btu-rov/Timsah/CAD_Files/Timsah_3.PNG

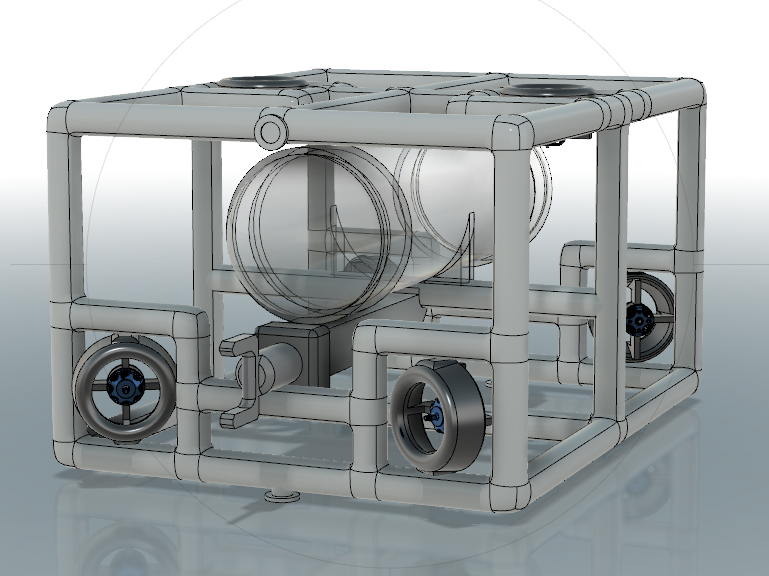
CAD_Files/Timsah_3.PNG
