btu-rov/Timsah/Schemes/time-management.jpg

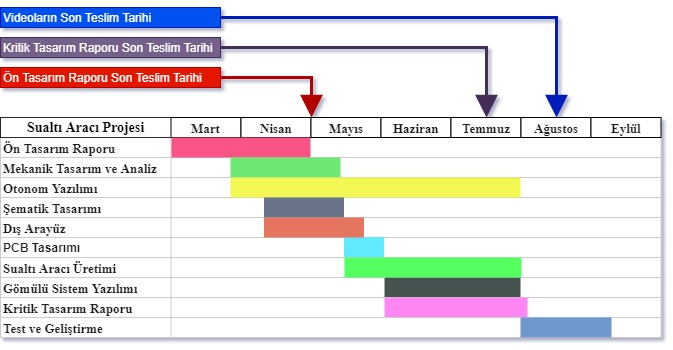
Schemes/time-management.jpg
