btu-rov/Timsah/README.md

# Timsah
This is Open Source ROV project which is made by Bursa Technical University ROV Team.
