btu-rov/Timsah/CAD_Files/Timsah_1.png

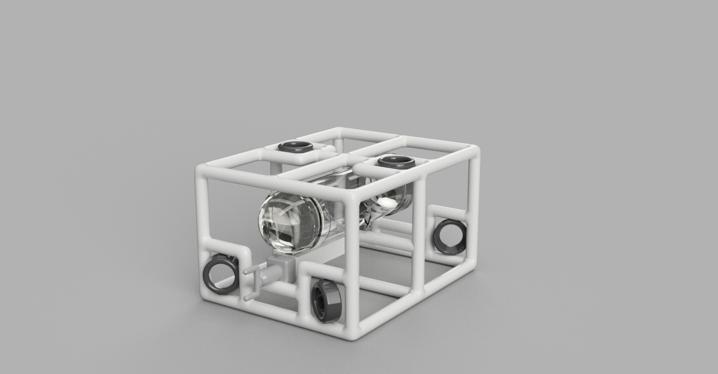
CAD_Files/Timsah_1.png
