btu-rov/Timsah/CAD_Files/Timsah_2.png

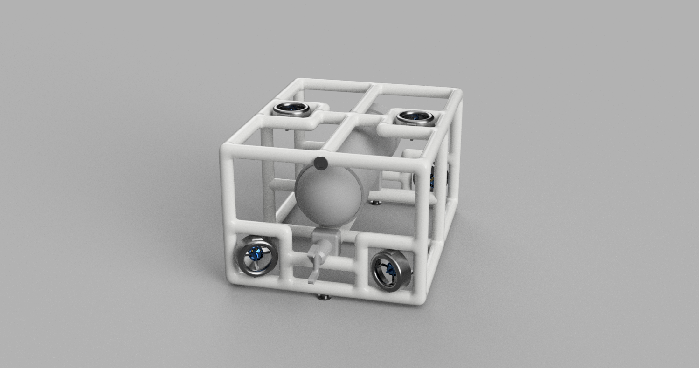
CAD_Files/Timsah_2.png
