btu-rov/Timsah/Schemes/control-center-algorithm.png

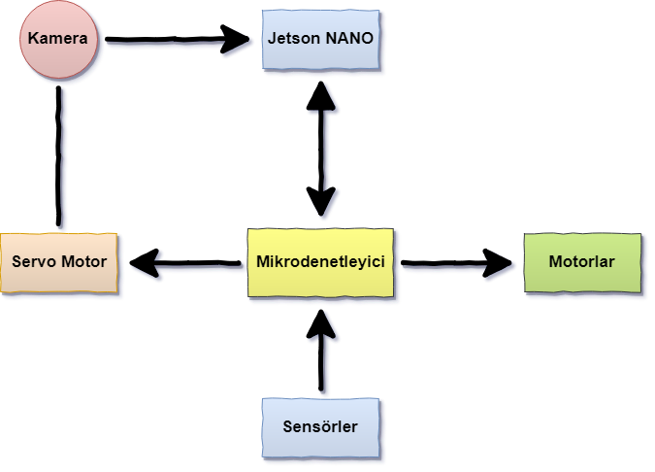
Schemes/control-center-algorithm.png
