btu-rov/Timsah/Schemes/direction-control.png

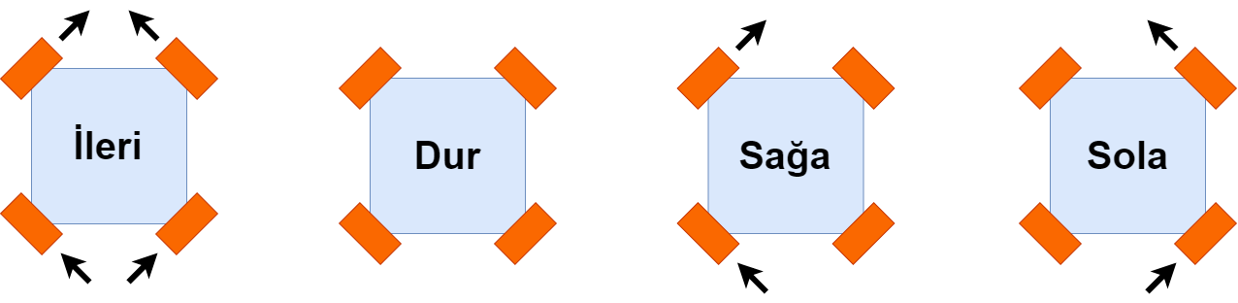
Schemes/direction-control.png
