btu-rov/Timsah/Schemes/ISS_Blok_Diagram.png

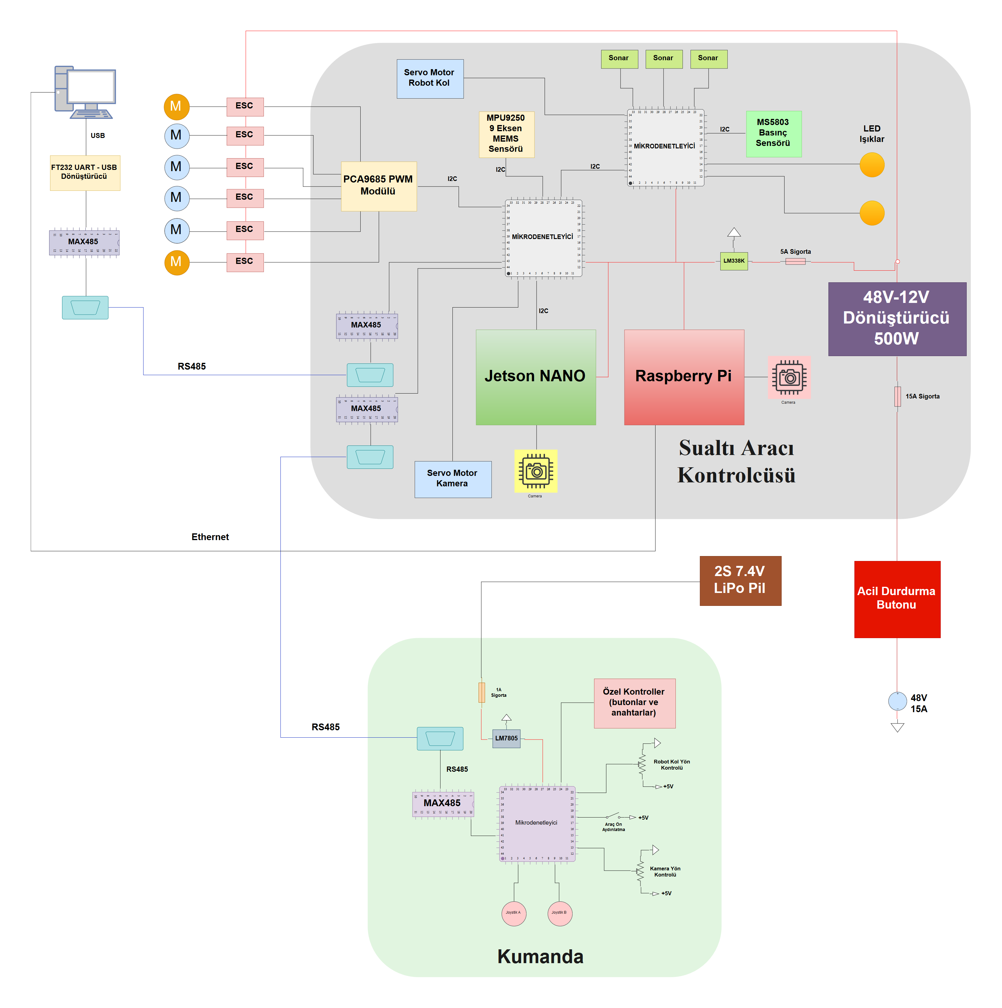
Schemes/ISS_Blok_Diagram.png
