btu-rov/Timsah/Schemes/object-searching-and-moving.png

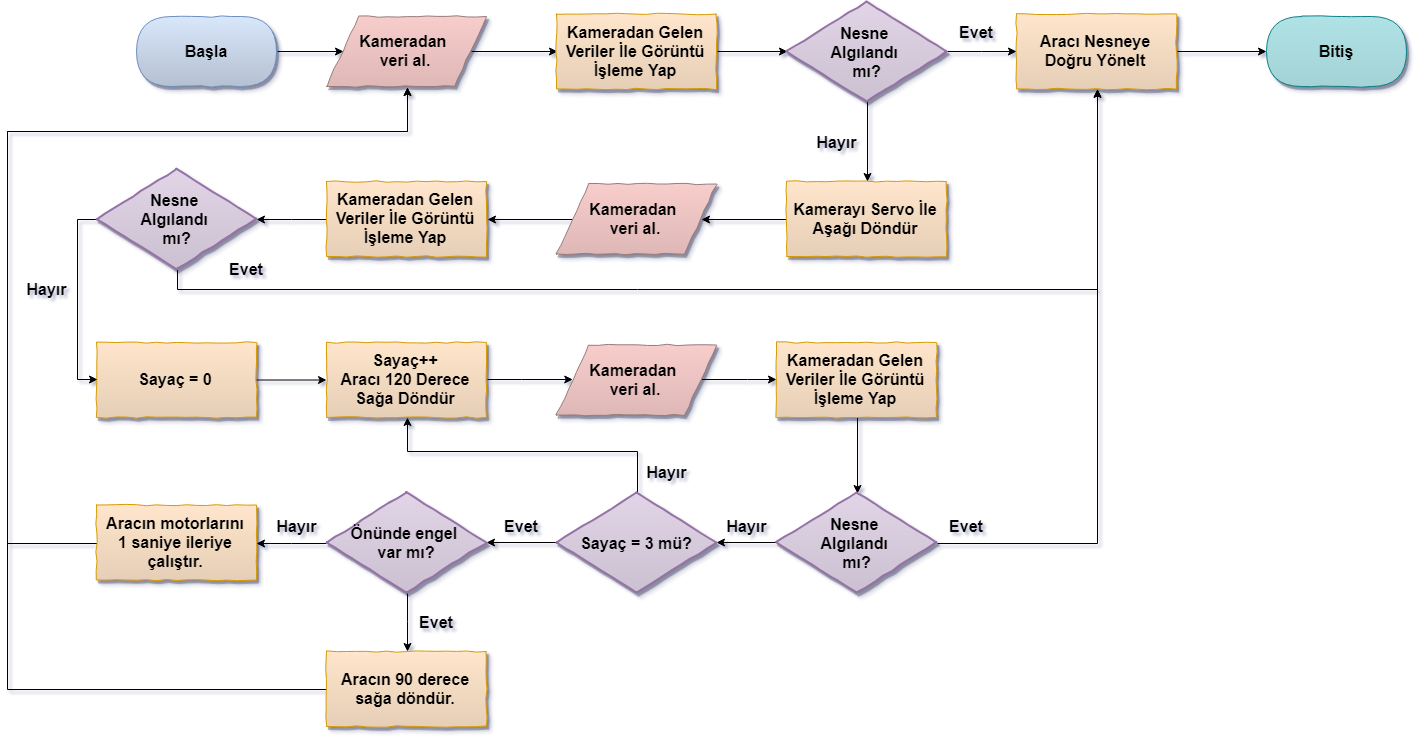
Schemes/object-searching-and-moving.png
