btu-rov/Timsah/Schemes/organization-schema.png

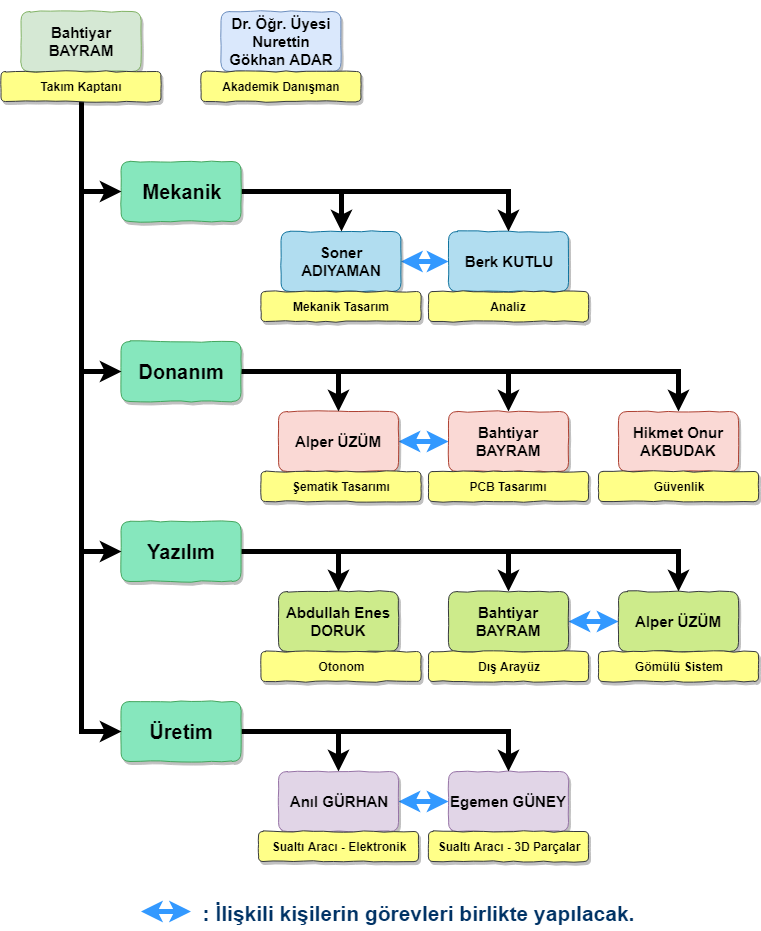
Schemes/organization-schema.png
