btu-rov/Timsah/Schemes/time-management.png

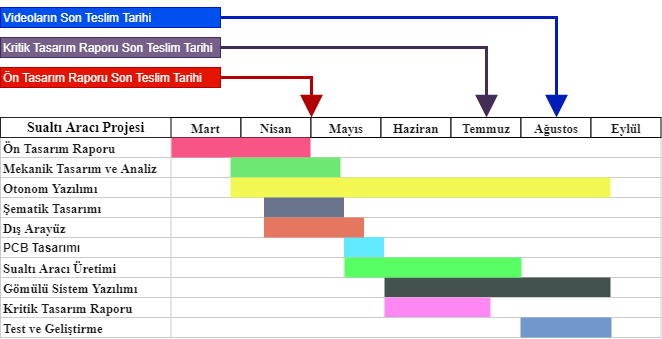
Schemes/time-management.png
