btu-rov/Timsah/Timsah_Remote-Control/Timsah_Remote-Control-3D.png

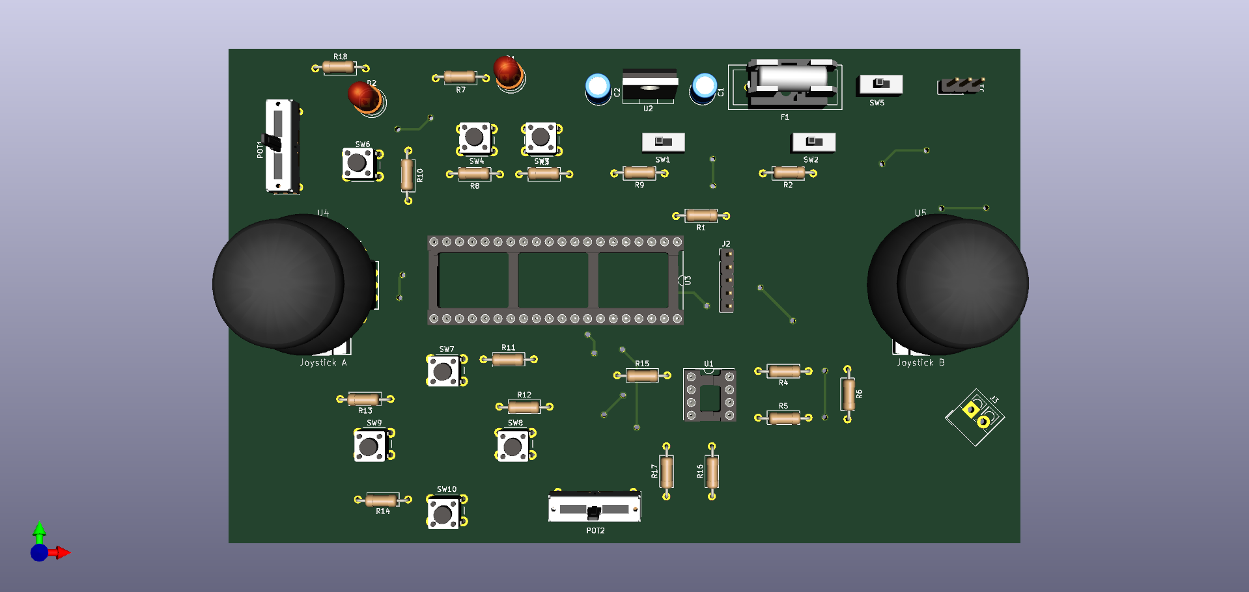
Timsah_Remote-Control/Timsah_Remote-Control-3D.png
