btu-rov/Timsah/Timsah_Remote-Control/Timsah_Remote_Control-B_Cu.PNG

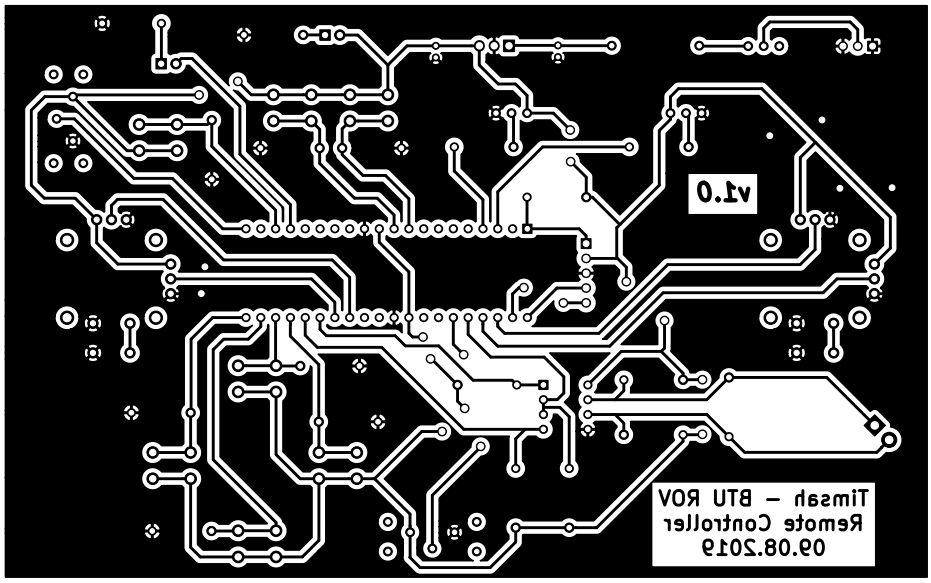
Timsah_Remote-Control/Timsah_Remote_Control-B_Cu.PNG
