btu-rov/Timsah/TimsahGUI/TimsahGUI.PNG

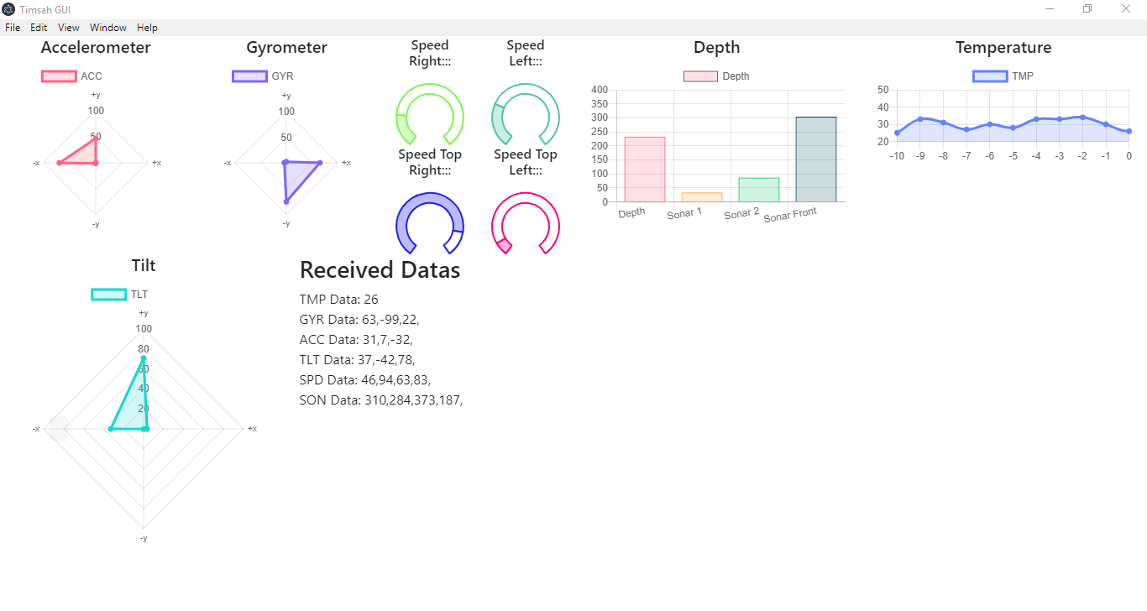
TimsahGUI/TimsahGUI.PNG
