btu-rov/Timsah/CAD_Files/Transparent_Tube.step

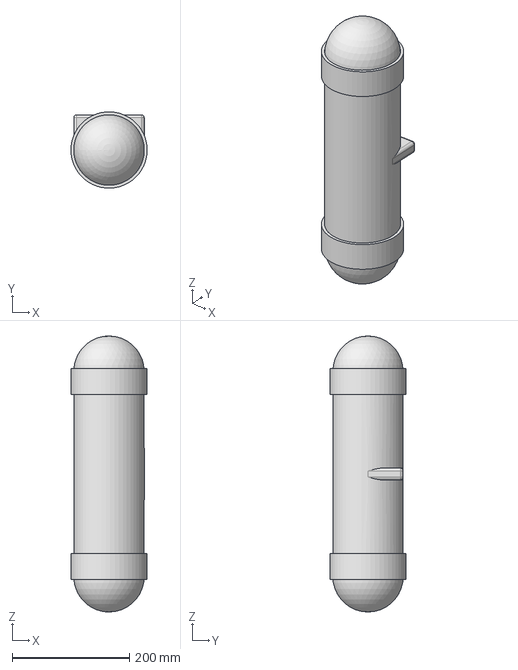
[picture p14: CAD file, 2019-05-17]
CAD_Files/Transparent_Tube.step
129.9 x 129.9 x 470.0 mm
