btu-rov/Timsah/Timsah_Main_Board/3D-Parts/Adafruit_BNO055_AP214.STEP

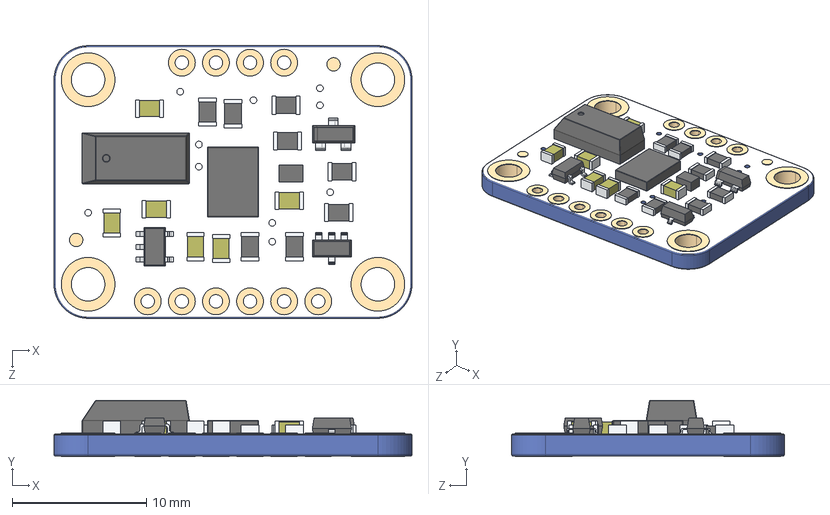
[picture p15: CAD file, 2019-08-28]
Timsah_Main_Board/3D-Parts/Adafruit_BNO055_AP214.STEP
26.7 x 4.20 x 20.3 mm
