btu-rov/Timsah/Timsah_Remote-Control/3D-Parts/Slide potentiometers.step

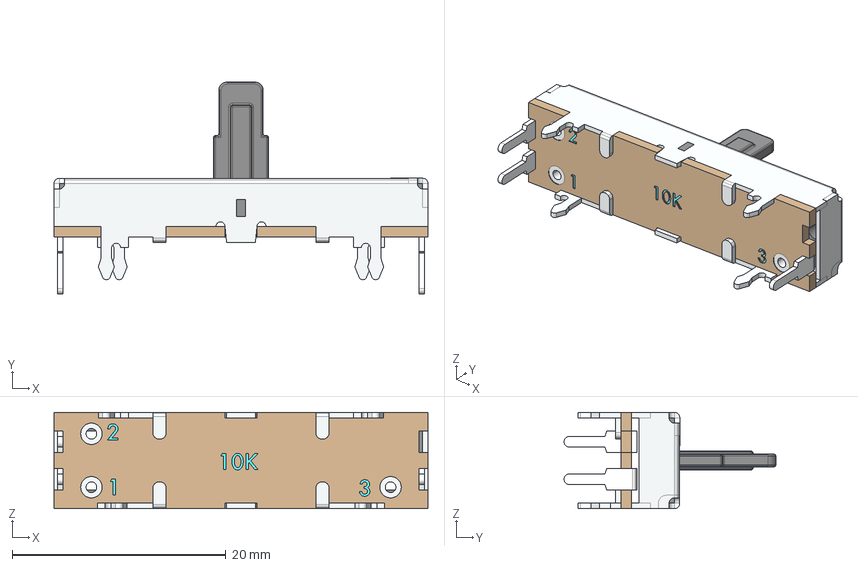
[picture p16: CAD file, 2019-07-26]
Timsah_Remote-Control/3D-Parts/Slide potentiometers.step
35.0 x 19.8 x 9.00 mm
