btu-rov/Timsah/CAD_Files/Motor_Holder.step

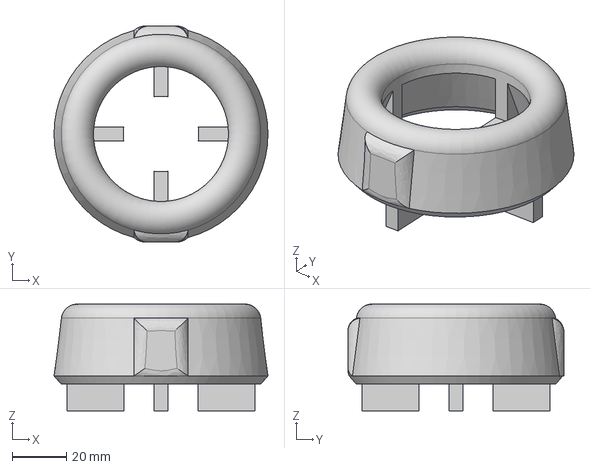
[picture p17: CAD file, 2019-05-17]
CAD_Files/Motor_Holder.step
79.3 x 80.0 x 39.6 mm
