btu-rov/Timsah/Timsah_Remote-Control/3D-Parts/Joystickcolor.step

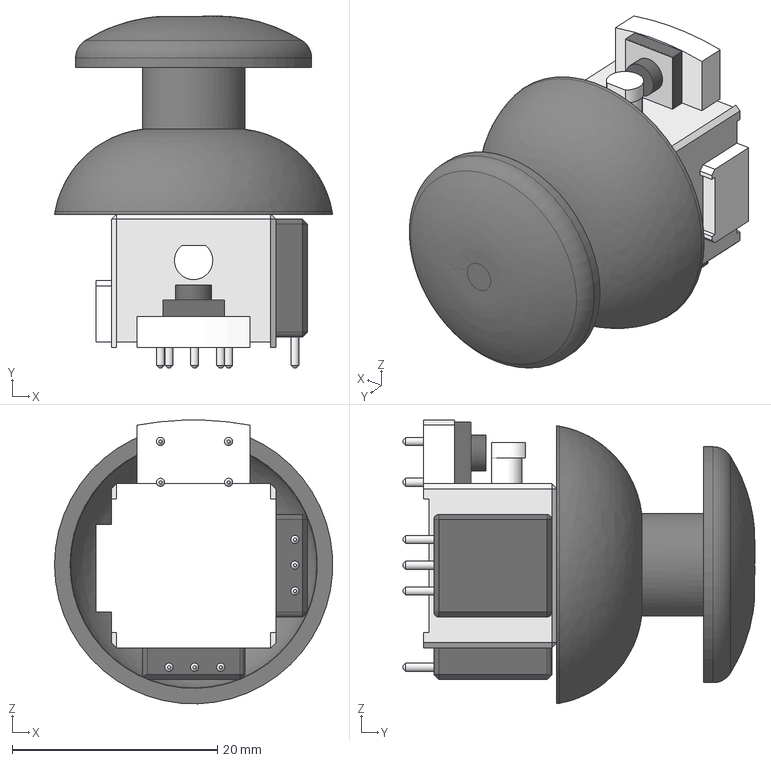
[picture p18: CAD file, 2019-07-26]
Timsah_Remote-Control/3D-Parts/Joystickcolor.step
27.1 x 34.3 x 27.6 mm
