btu-rov/Timsah/CAD_Files/Sonar.step

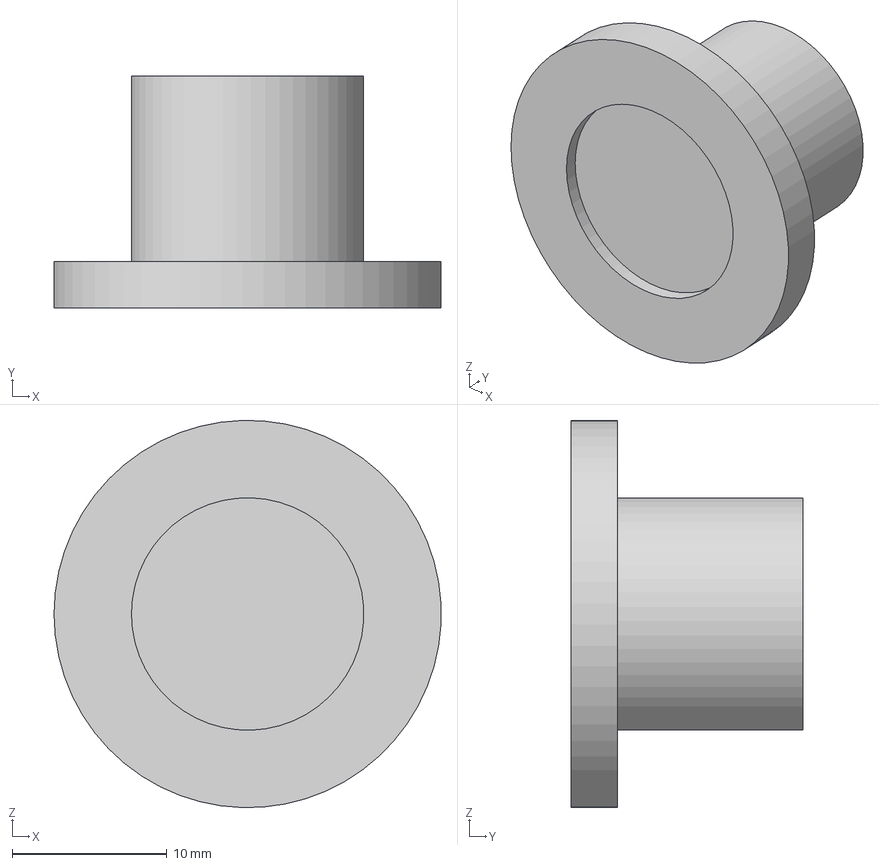
[picture p19: CAD file, 2019-05-17]
CAD_Files/Sonar.step
25.0 x 15.0 x 25.0 mm
