btu-rov/Timsah/Timsah_Main_Board/3D-Parts/Vertical slide switch SS-12D00G3 High Knob 3mm SPDT v2.step

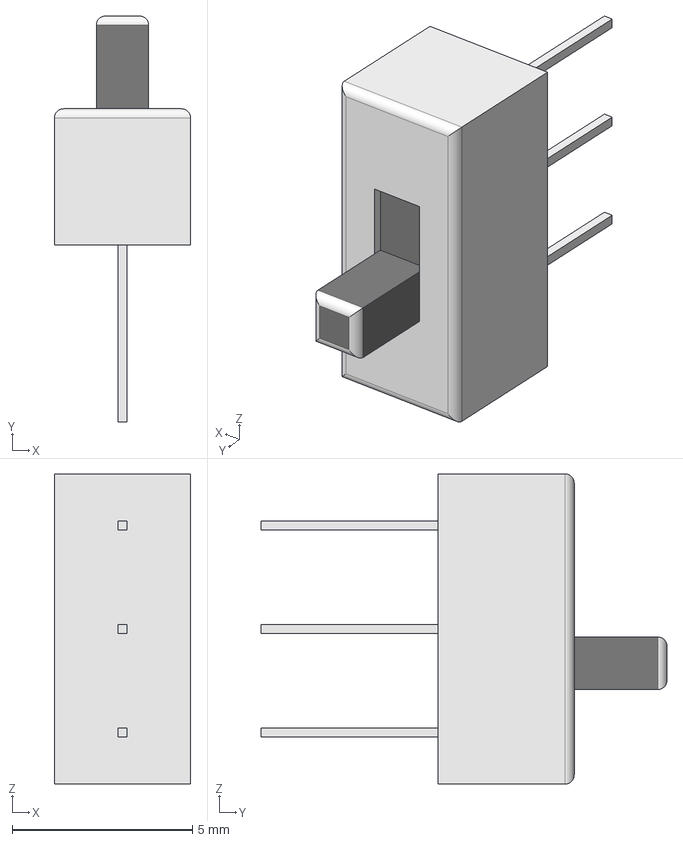
[picture p20: CAD file, 2019-07-26]
Timsah_Main_Board/3D-Parts/Vertical slide switch SS-12D00G3 High Knob 3mm SPDT v2.step
3.77 x 11.2 x 8.59 mm
