btu-rov/Timsah/CAD_Files/Robot_Arm.step

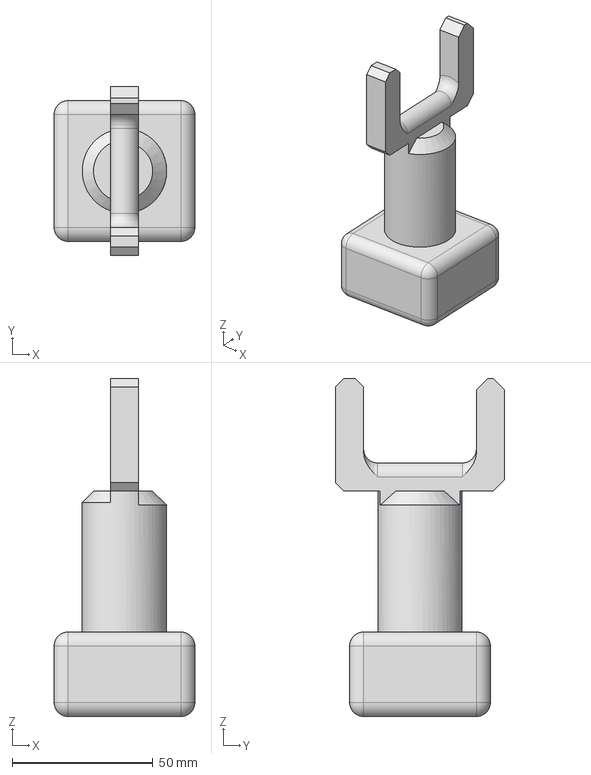
[picture p21: CAD file, 2019-05-17]
CAD_Files/Robot_Arm.step
50.0 x 60.0 x 120.0 mm
