btu-rov/Timsah/Timsah_Main_Board/3D-Parts/LITTLEFUSE_FuseBlock_646_v2.step

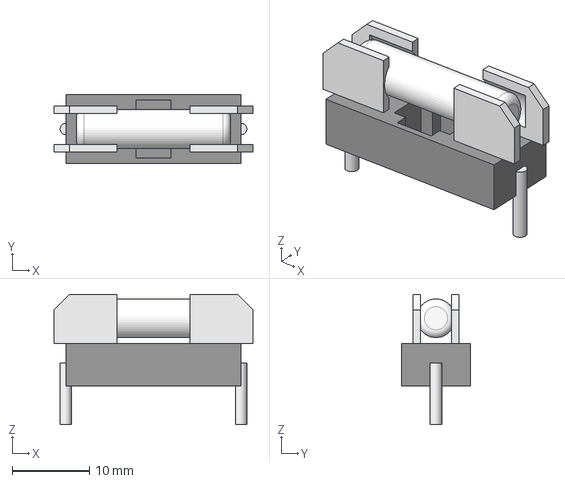
[picture p22: CAD file, 2019-07-26]
Timsah_Main_Board/3D-Parts/LITTLEFUSE_FuseBlock_646_v2.step
25.8 x 9.00 x 16.9 mm
