btu-rov/Timsah/Timsah_Main_Board/3D-Parts/ScrewTerminal.STEP

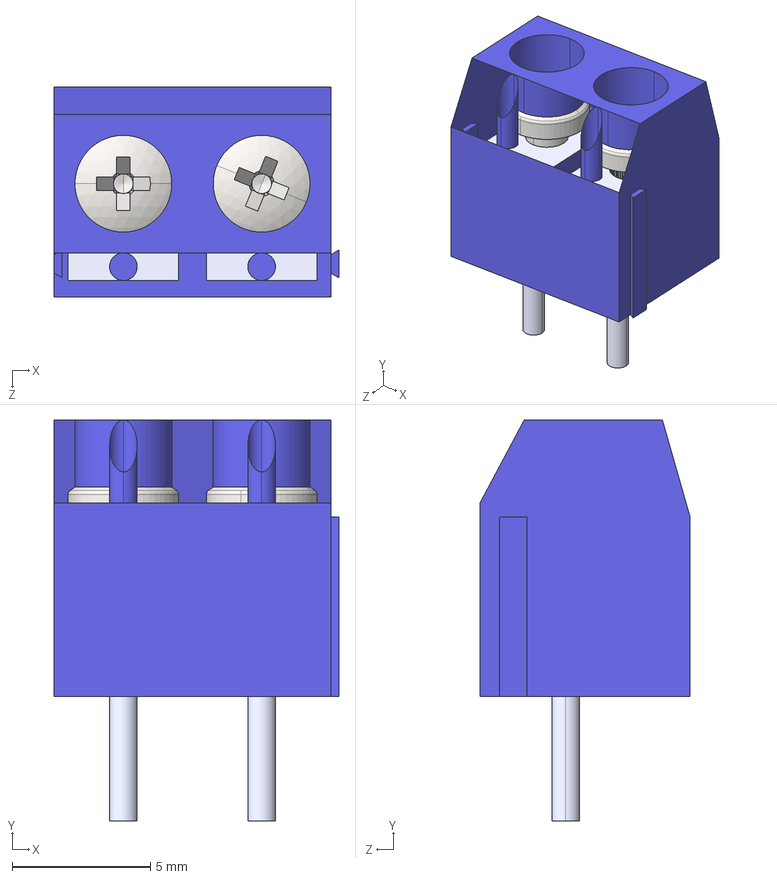
[picture p23: CAD file, 2019-08-28]
Timsah_Main_Board/3D-Parts/ScrewTerminal.STEP
10.3 x 14.5 x 7.60 mm
ScrewTerminalCover
Pin x 2
pan head cross recess screw_iso_ISO 7045 - M2 x 3 - Z - 3N x 2
