btu-rov/Timsah/Schemes/image-processing-steps.png

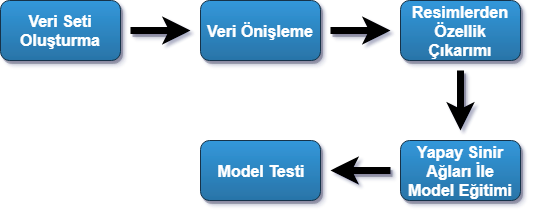
Schemes/image-processing-steps.png
