btu-rov/Timsah/Timsah_Main_Board/Timsah_Main_Board.pdf

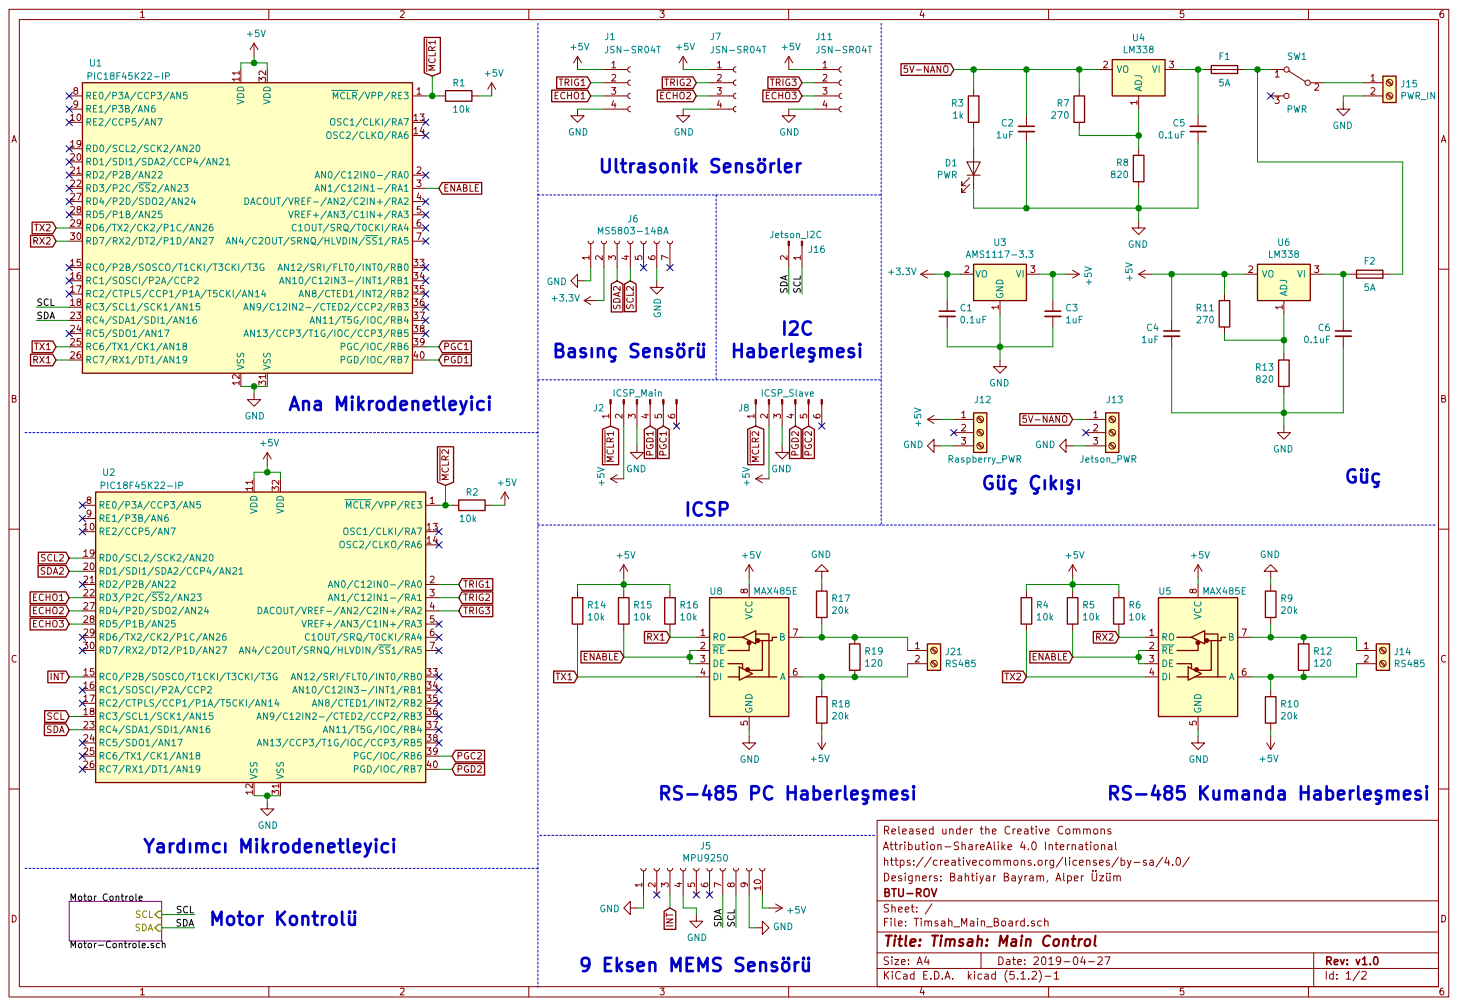
[picture p25: page 1]

Jetson_I2C

ICSP

https://creativecommons.org/licenses/by-sa/4.0/ Attribution-ShareAlike 4.0 International Released under the Creative Commons

File: Timsah_Main_Board.sch Sheet: / BTU-ROV Designers: Bahtiyar Bayram, Alper Üzüm

Motor Controle Motor-Controle.sch SCL SDA

Id: 1/2 Title: Timsah: Main Control

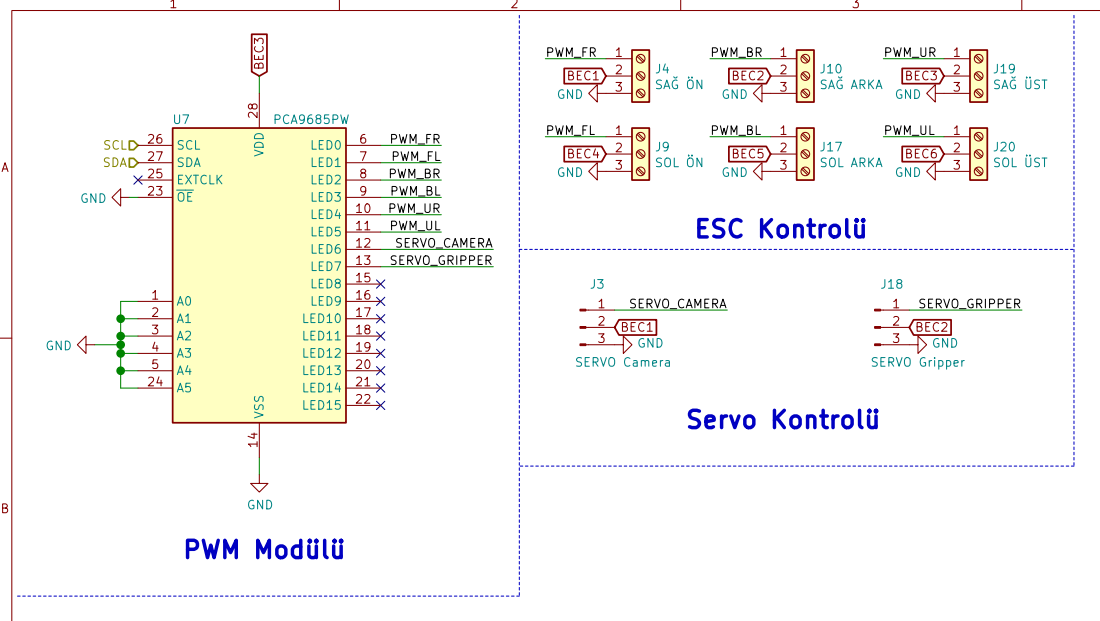
[picture p26: page 2]

Id: 2/2 Title: File: Motor-Controle.sch Sheet: /Motor Controle/
