btu-rov/Timsah/Schemes/ISS_Blok_Diagram.pdf

# MİKRODENETLEYİCİ

# ESC

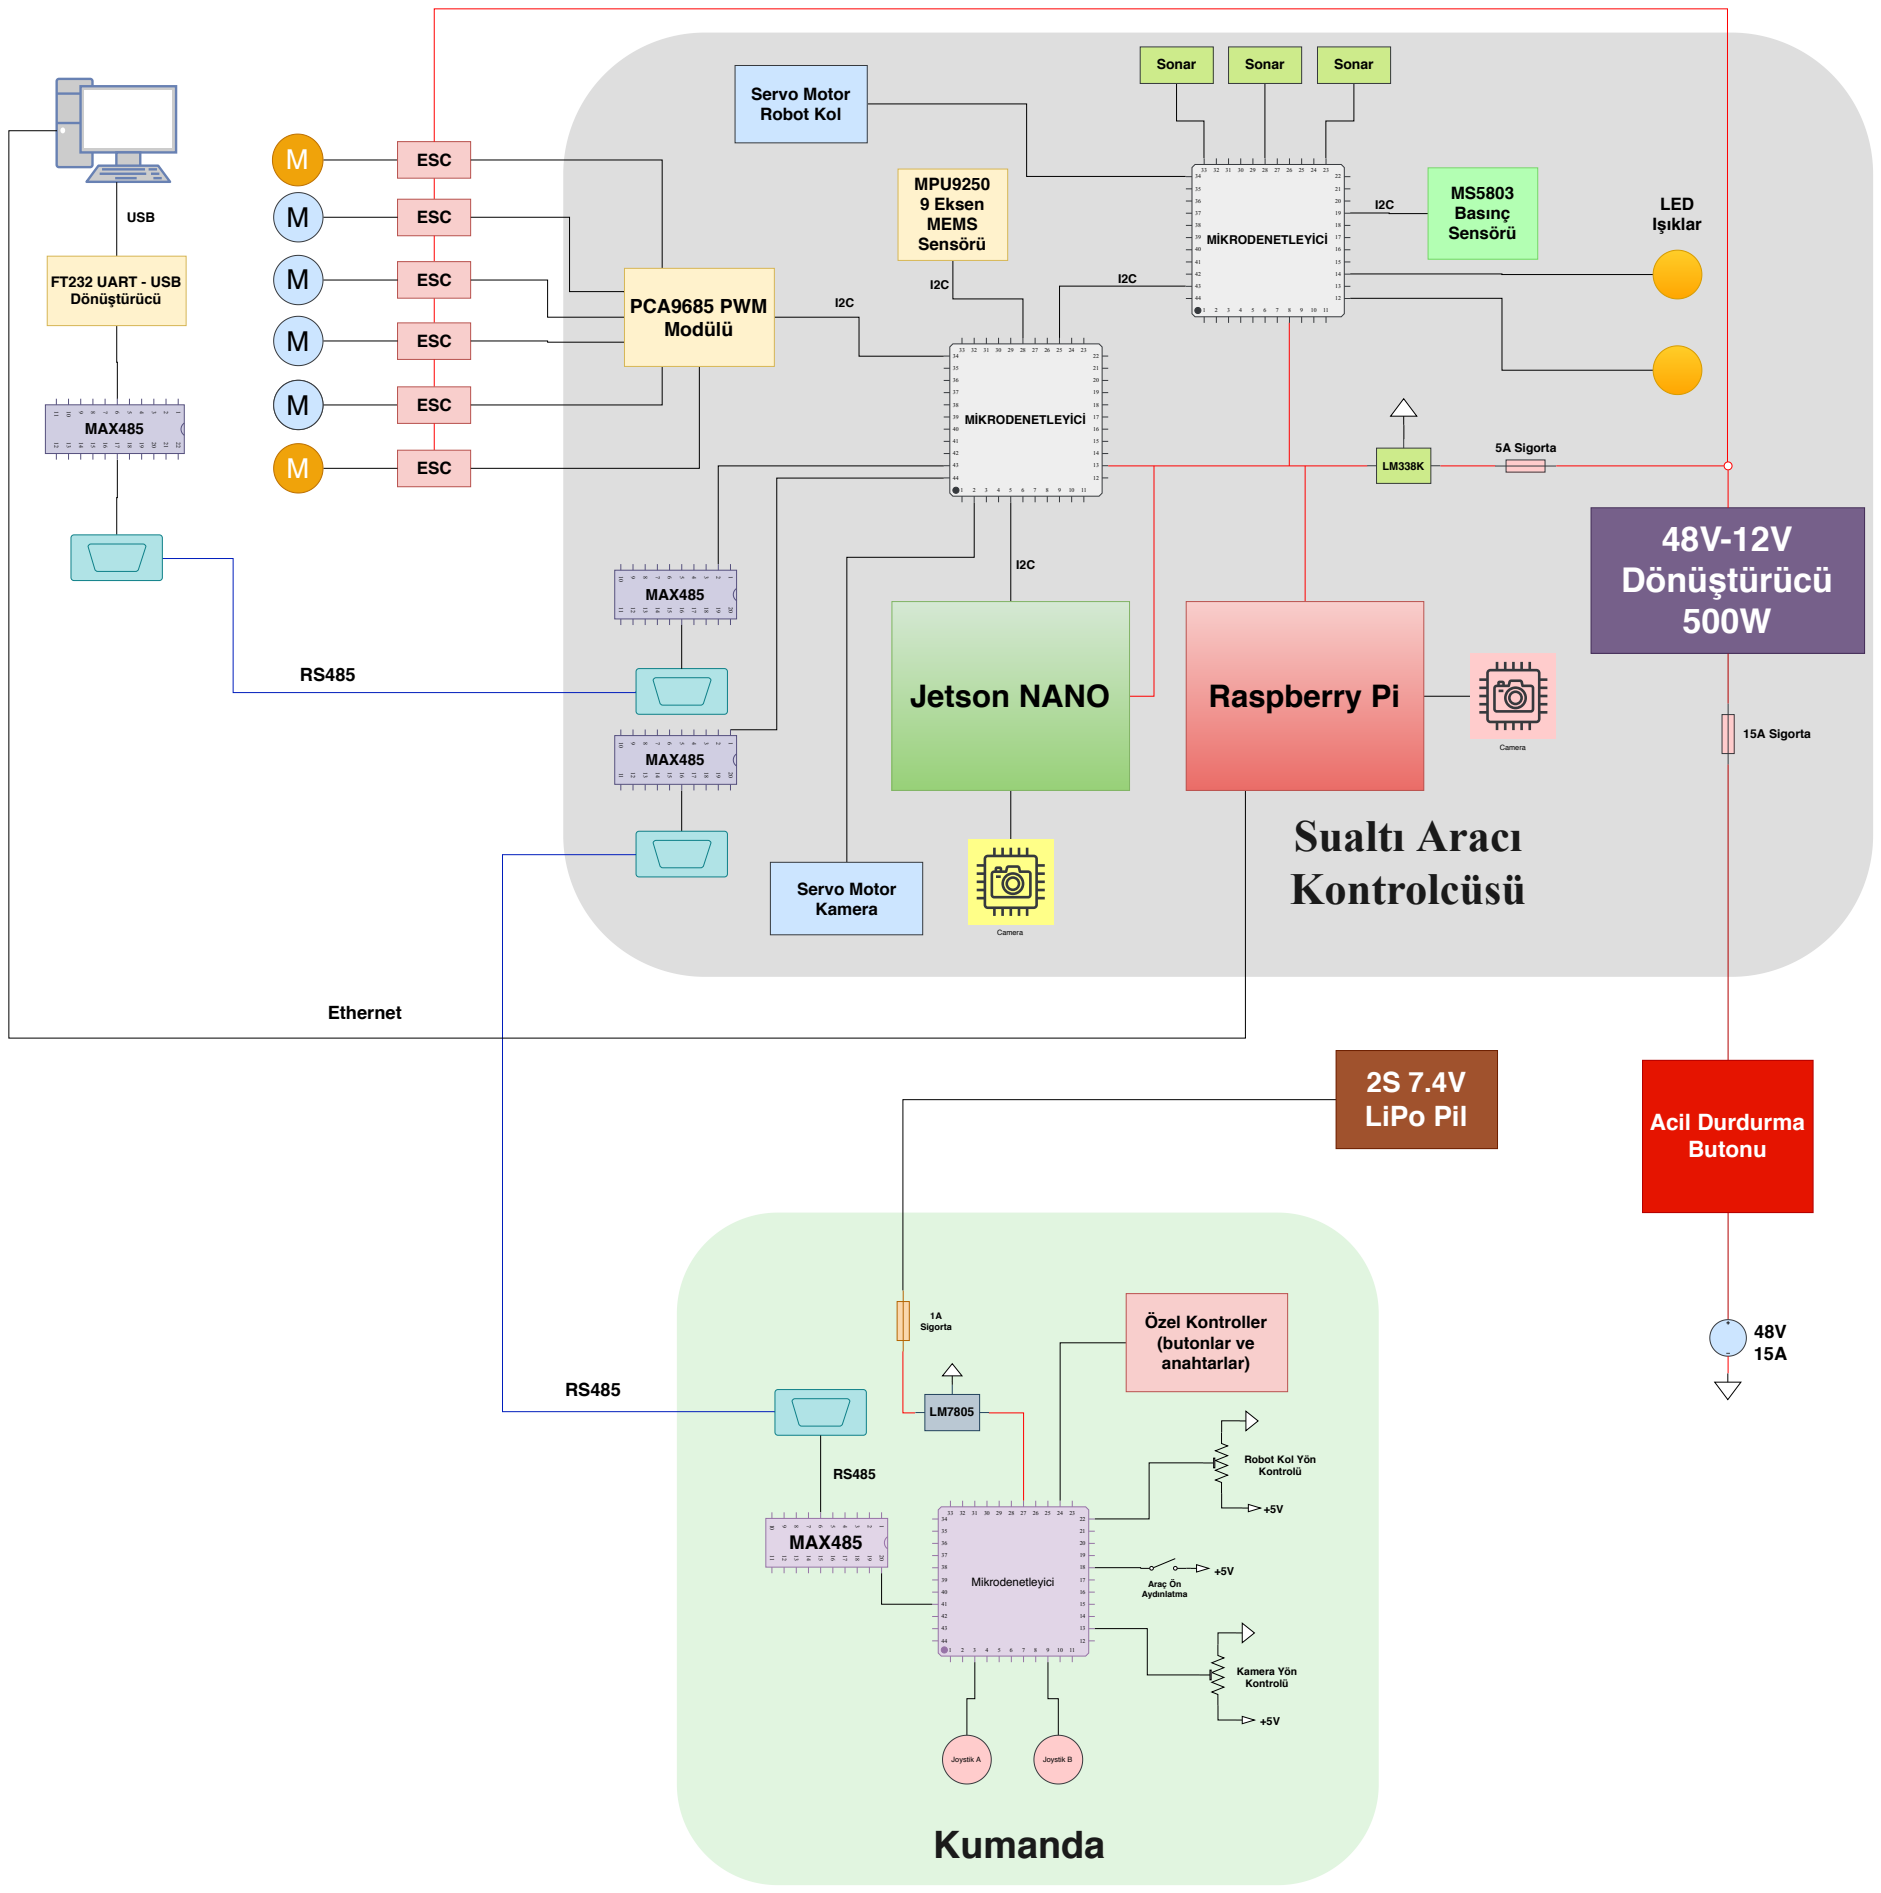
[picture p27: page 1]
ESC; MPU9250 9 Eksen MEMS Sensörü; Jetson NANO; Camera; 5A Sigorta; Servo Motor Kamera; Sonar; MAX485; USB; Sualtı Aracı Kontrolcüsü; Mikrodenetleyici; 1A Sigorta; Joystik A; Joystik B; Araç Ön Aydınlatma; Kamera Yön Kontrolü; Kumanda; Özel Kontroller (butonlar ve anahtarlar); MİKRODENETLEYİCİ; MS5803 Basınç Sensörü; LED; Işıklar; Raspberry Pi; Ethernet; FT232 UART - USB Dönüştürücü; 48V-12V Dönüştürücü 500W; PCA9685 PWM Modülü; Servo Motor Robot Kol; 2S 7.4V LiPo Pil; 15A Sigorta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

Robot Kol Yön
Kontrolü
