btu-rov/Timsah/Timsah_Remote-Control/Timsah_Remote-Control-B_Cu.pdf

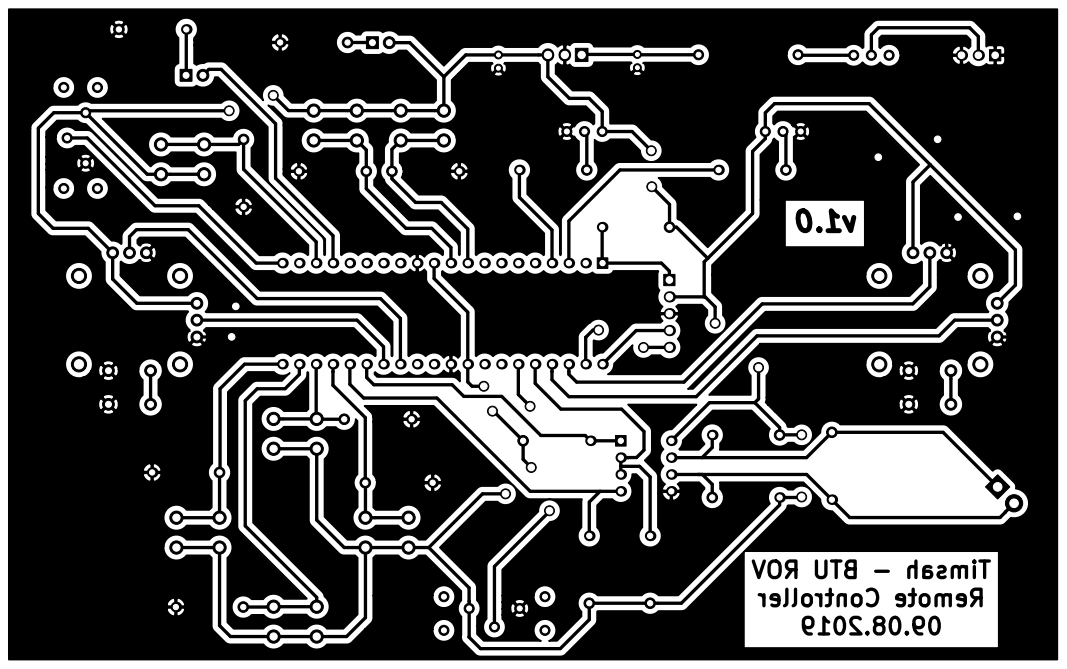
[picture p28: page 1]
