btu-rov/Timsah/Timsah_Remote-Control/Timsah_Remote-Control.pdf

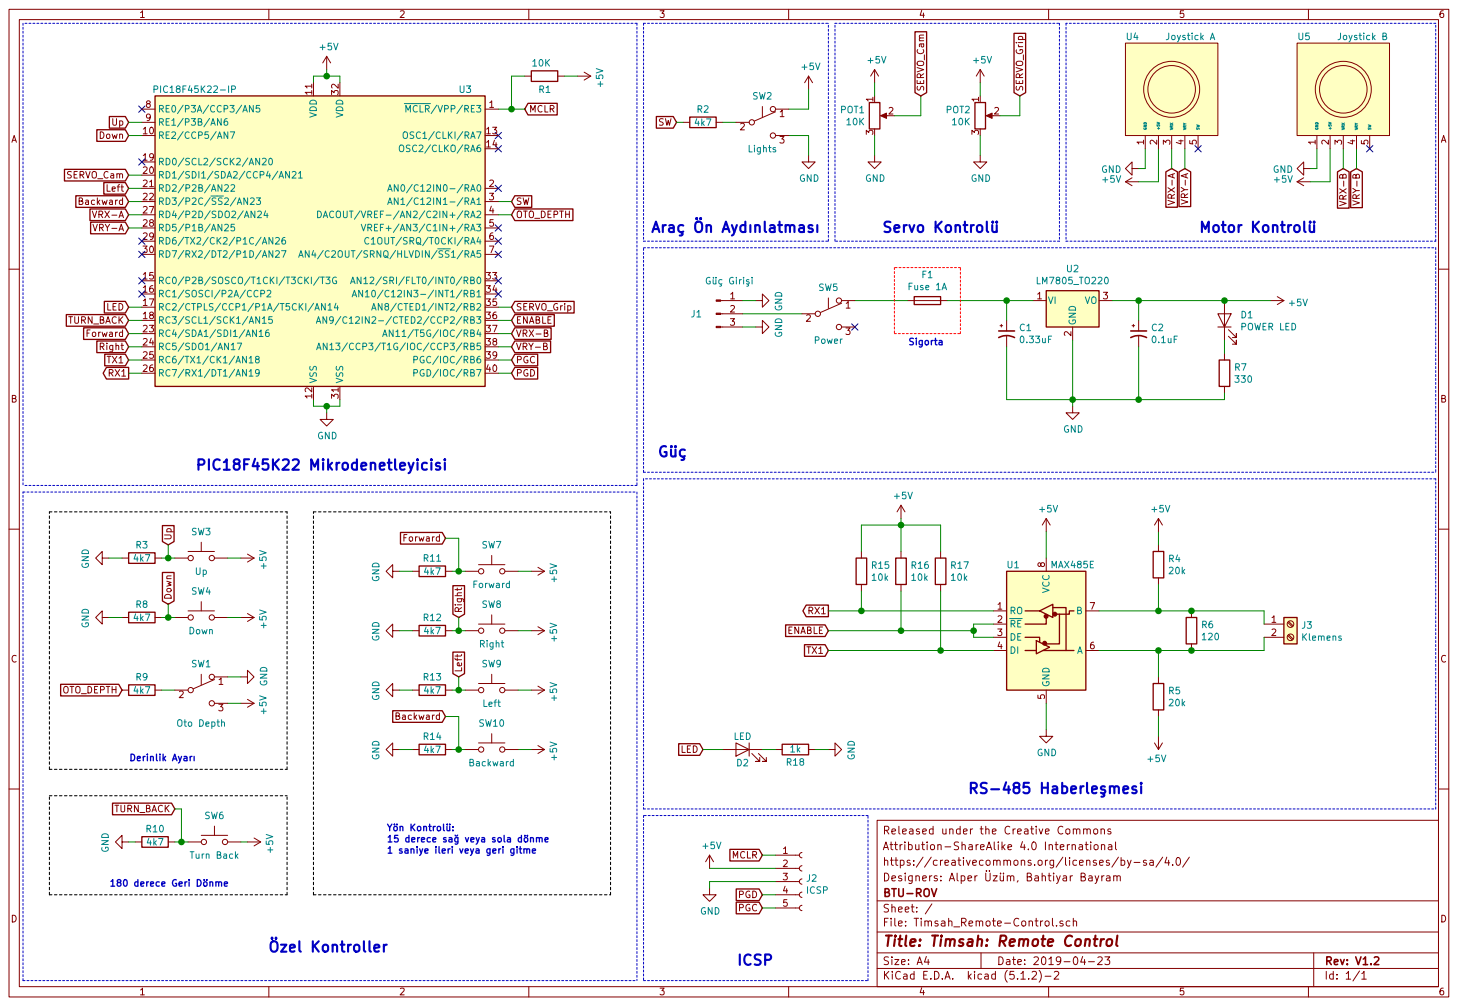
[picture p29: page 1]
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

1 saniye ileri veya geri gitme

File: Timsah_Remote-Control.sch Sheet: / BTU-ROV Designers: Alper Üzüm, Bahtiyar Bayram

Id: 1/1 Title: Timsah: Remote Control
