btu-rov/Timsah/Timsah_Main_Board/Timsah_Main_Board.kicad_pcb

## KiCad design Timsah_Main_Board/Timsah_Main_Board.kicad_pcb (2019-08-29)

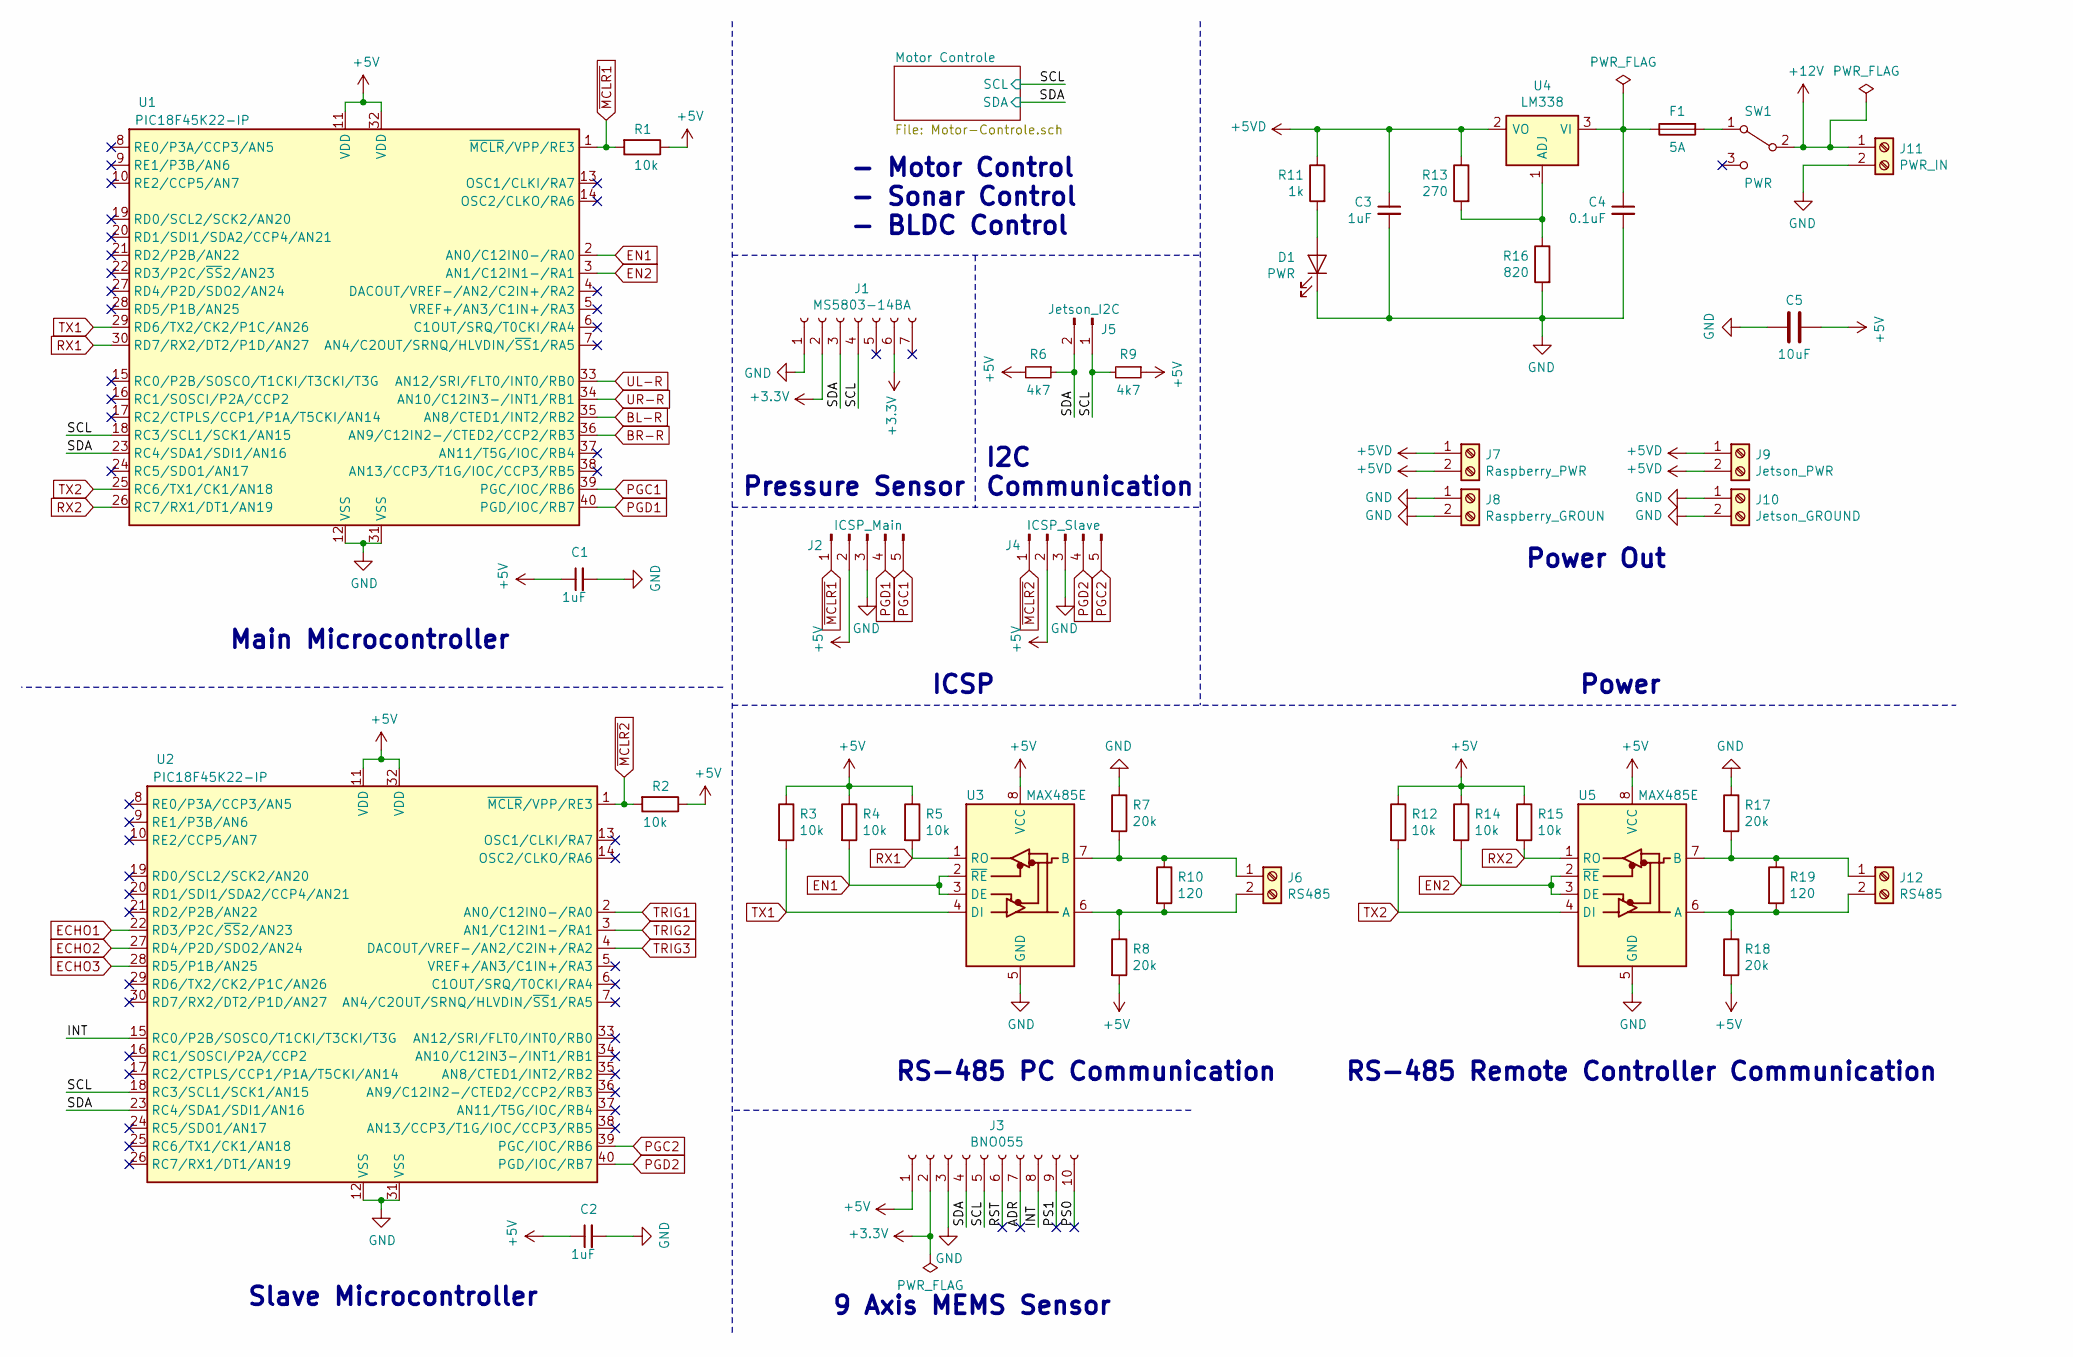
[picture p30: schematic Timsah_Main_Board.sch, Timsah: Main Control]

Parts:
C1, C2, C3: 1uF; C_0805_2012Metric_Pad1.15x1.40mm_HandSolder
C4: 0.1uF; C_0805_2012Metric_Pad1.15x1.40mm_HandSolder
C5: 10uF; C_0805_2012Metric_Pad1.15x1.40mm_HandSolder
D1: PWR; LED_0805_2012Metric_Pad1.15x1.40mm_HandSolder
F1: 5A; Fuseholder_23x9x10mm
J1: MS5803-14BA; PinSocket_1x07_P2.54mm_Vertical
J2: ICSP_Main; PinSocket_1x05_P2.54mm_Vertical
J3: BNO055; BNO055-Module_Adafruit
J4: ICSP_Slave; PinSocket_1x05_P2.54mm_Vertical
J5: Jetson_I2C; PinHeader_1x02_P2.54mm_Vertical
J6, J12: RS485; TerminalBlock_4Ucon_1x02_P3.50mm_Vertical
J7: Raspberry_PWR; TerminalBlock_4Ucon_1x02_P3.50mm_Vertical
J8: Raspberry_GROUN; TerminalBlock_4Ucon_1x02_P3.50mm_Vertical
J9: Jetson_PWR; TerminalBlock_4Ucon_1x02_P3.50mm_Vertical
J10: Jetson_GROUND; TerminalBlock_4Ucon_1x02_P3.50mm_Vertical
J11: PWR_IN; TerminalBlock_bornier-2_P5.08mm
R1, R2, R3, R4, R5, R12, R14, R15: 10k; R_0805_2012Metric_Pad1.15x1.40mm_HandSolder
R6, R9: 4k7; R_0805_2012Metric_Pad1.15x1.40mm_HandSolder
R7, R8, R17, R18: 20k; R_0805_2012Metric_Pad1.15x1.40mm_HandSolder
R10, R19: 120; R_Axial_DIN0207_L6.3mm_D2.5mm_P10.16mm_Horizontal
R11: 1k; R_0805_2012Metric_Pad1.15x1.40mm_HandSolder
R13: 270; R_Axial_DIN0207_L6.3mm_D2.5mm_P10.16mm_Horizontal
R16: 820; R_Axial_DIN0207_L6.3mm_D2.5mm_P10.16mm_Horizontal
SW1: PWR; SW_Slide_1P2T_0.105pitch
U1, U2: PIC18F45K22-IP; DIP-40_W15.24mm_Socket
U3, U5: MAX485E; DIP-8_W7.62mm_Socket
U4: LM338; TO-3

Connections:
+3V3: J1.2, J1.6, J3.2
+5VD: C3.1, J7.1, J7.2, J9.1, J9.2, R11.1, R13.1, U4.2 (VO)
+12V: J11.1, SW1.2 (B); also elsewhere on the board
/ADR: J3.7
/INT: J3.8, U2.15 (RC0/P2B/SOSCO/T1CKI/T3CKI/T3G)
/PS0: J3.10
/PS1: J3.9
/RST: J3.6
/SCL: J1.4, J3.5, J5.1, R9.2, U1.18 (RC3/SCL1/SCK1/AN15), U2.18 (RC3/SCL1/SCK1/AN15); also elsewhere on the board
/SDA: J1.3, J3.4, J5.2, R6.1, U1.23 (RC4/SDA1/SDI1/AN16), U2.23 (RC4/SDA1/SDI1/AN16); also elsewhere on the board
BEC: C1.1, C2.1, C5.1, J2.2, J3.1, J4.2, R1.1, R2.1, R3.1, R4.1, R5.1, R6.2, R8.2, R9.1, R12.1, R14.1, R15.1, R18.2, U1.11 (VDD), U1.32 (VDD), U2.11 (VDD), U2.32 (VDD), U3.8 (VCC), U5.8 (VCC); also elsewhere on the board
BL-R: U1.35 (AN8/CTED1/INT2/RB2); also elsewhere on the board
BR-R: U1.36 (AN9/C12IN2-/CTED2/CCP2/RB3); also elsewhere on the board
ECHO1: U2.22 (RD3/P2C/~SS~2/AN23); also elsewhere on the board
ECHO2: U2.27 (RD4/P2D/SDO2/AN24); also elsewhere on the board
ECHO3: U2.28 (RD5/P1B/AN25); also elsewhere on the board
EN1: R4.2, U1.2 (AN0/C12IN0-/RA0), U3.2 (~RE), U3.3 (DE)
EN2: R14.2, U1.3 (AN1/C12IN1-/RA1), U5.2 (~RE), U5.3 (DE)
GND: C1.2, C2.2, C3.2, C4.2, C5.2, D1.1 (K), J1.1, J2.3, J3.3, J4.3, J8.1, J8.2, J10.1, J10.2, J11.2, R7.1, R16.2, R17.1, U1.12 (VSS), U1.31 (VSS), U2.12 (VSS), U2.31 (VSS), U3.5 (GND), U5.5 (GND); also elsewhere on the board
unnamed: C4.1, F1.1, U4.3 (VI)
unnamed: D1.2 (A), R11.2
unnamed: F1.2, SW1.1 (A)
unnamed: J6.1, R7.2, R10.1, U3.7 (B)
unnamed: J6.2, R8.1, R10.2, U3.6 (A)
unnamed: J12.1, R17.2, R19.1, U5.7 (B)
unnamed: J12.2, R18.1, R19.2, U5.6 (A)
unnamed: R13.2, R16.1, U4.1 (ADJ)
PGC1: J2.5, U1.39 (PGC/IOC/RB6)
PGC2: J4.5, U2.39 (PGC/IOC/RB6)
PGD1: J2.4, U1.40 (PGD/IOC/RB7)
PGD2: J4.4, U2.40 (PGD/IOC/RB7)
RX1: R5.2, U1.30 (RD7/RX2/DT2/P1D/AN27), U3.1 (RO)
RX2: R15.2, U1.26 (RC7/RX1/DT1/AN19), U5.1 (RO)
TRIG1: U2.2 (AN0/C12IN0-/RA0); also elsewhere on the board
TRIG2: U2.3 (AN1/C12IN1-/RA1); also elsewhere on the board
TRIG3: U2.4 (DACOUT/VREF-/AN2/C2IN+/RA2); also elsewhere on the board
TX1: R3.2, U1.29 (RD6/TX2/CK2/P1C/AN26), U3.4 (DI)
TX2: R12.2, U1.25 (RC6/TX1/CK1/AN18), U5.4 (DI)
UL-R: U1.33 (AN12/SRI/FLT0/INT0/RB0); also elsewhere on the board
UR-R: U1.34 (AN10/C12IN3-/INT1/RB1); also elsewhere on the board
~MCLR1: J2.1, R1.2, U1.1 (~MCLR~/VPP/RE3)
~MCLR2: J4.1, R2.2, U2.1 (~MCLR~/VPP/RE3)

Notes on the sheet:
Power
9 Axis MEMS Sensor
RS-485 Remote Controller Communication
Slave Microcontroller
Main Microcontroller
Pressure Sensor
ICSP
Power Out
I2C Communication
RS-485 PC Communication
- Motor Control - Sonar Control - BLDC Control

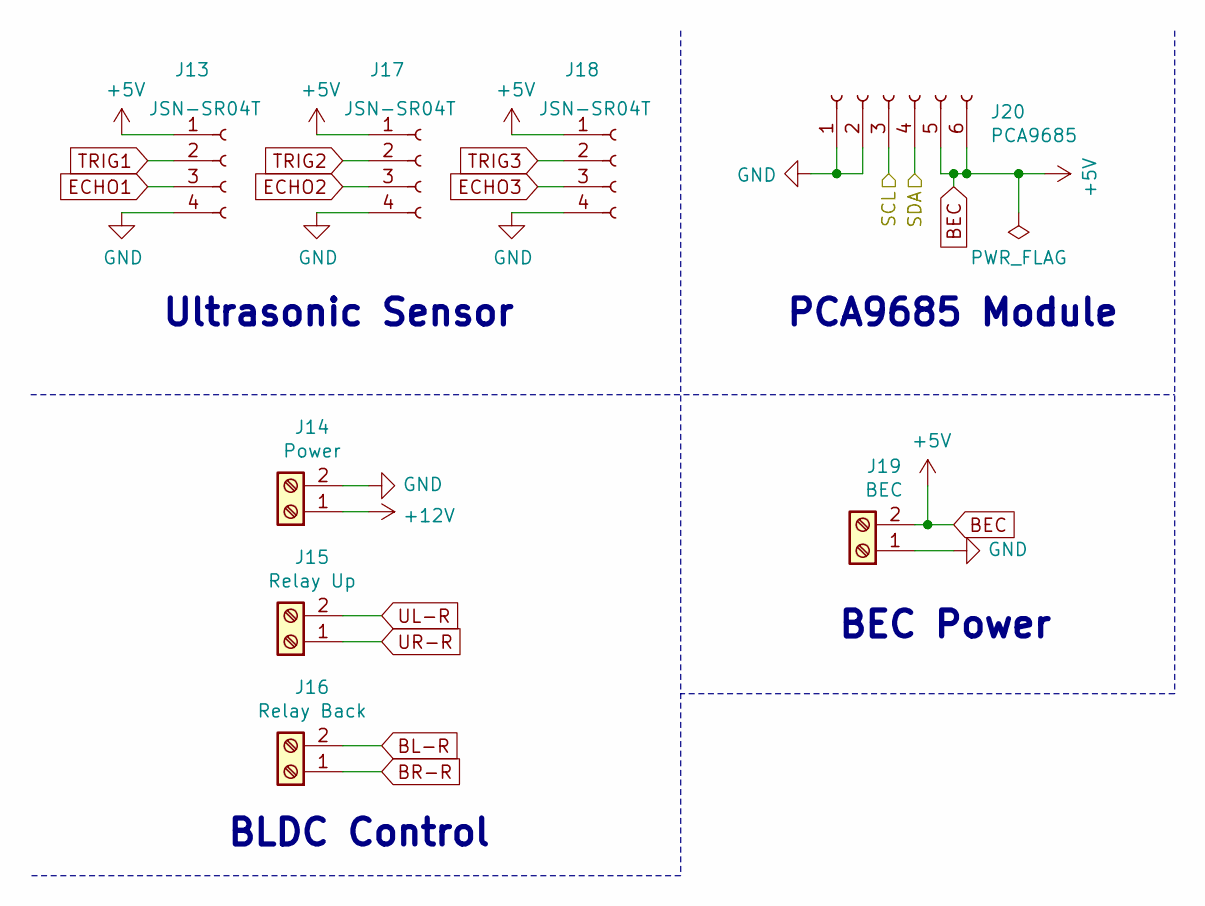
[picture p31: schematic Motor-Controle.sch, Timsah: Main Control]

Parts:
J13, J17, J18: JSN-SR04T; PinSocket_1x04_P2.54mm_Vertical
J14: Power; TerminalBlock_bornier-2_P5.08mm
J15: Relay Up; PinSocket_1x02_P2.54mm_Vertical
J16: Relay Back; PinSocket_1x02_P2.54mm_Vertical
J19: BEC; TerminalBlock_4Ucon_1x02_P3.50mm_Vertical
J20: PCA9685; PinSocket_1x06_P2.54mm_Vertical

Connections:
+12V: J14.1; also elsewhere on the board
/SCL: J20.3; also elsewhere on the board
/SDA: J20.4; also elsewhere on the board
BEC: J13.1, J17.1, J18.1, J19.2, J20.5, J20.6; also elsewhere on the board
BL-R: J16.2; also elsewhere on the board
BR-R: J16.1; also elsewhere on the board
ECHO1: J13.3; also elsewhere on the board
ECHO2: J17.3; also elsewhere on the board
ECHO3: J18.3; also elsewhere on the board
GND: J13.4, J14.2, J17.4, J18.4, J19.1, J20.1, J20.2; also elsewhere on the board
TRIG1: J13.2; also elsewhere on the board
TRIG2: J17.2; also elsewhere on the board
TRIG3: J18.2; also elsewhere on the board
UL-R: J15.2; also elsewhere on the board
UR-R: J15.1; also elsewhere on the board

Notes on the sheet:
BLDC Control
Ultrasonic Sensor
PCA9685 Module
BEC Power

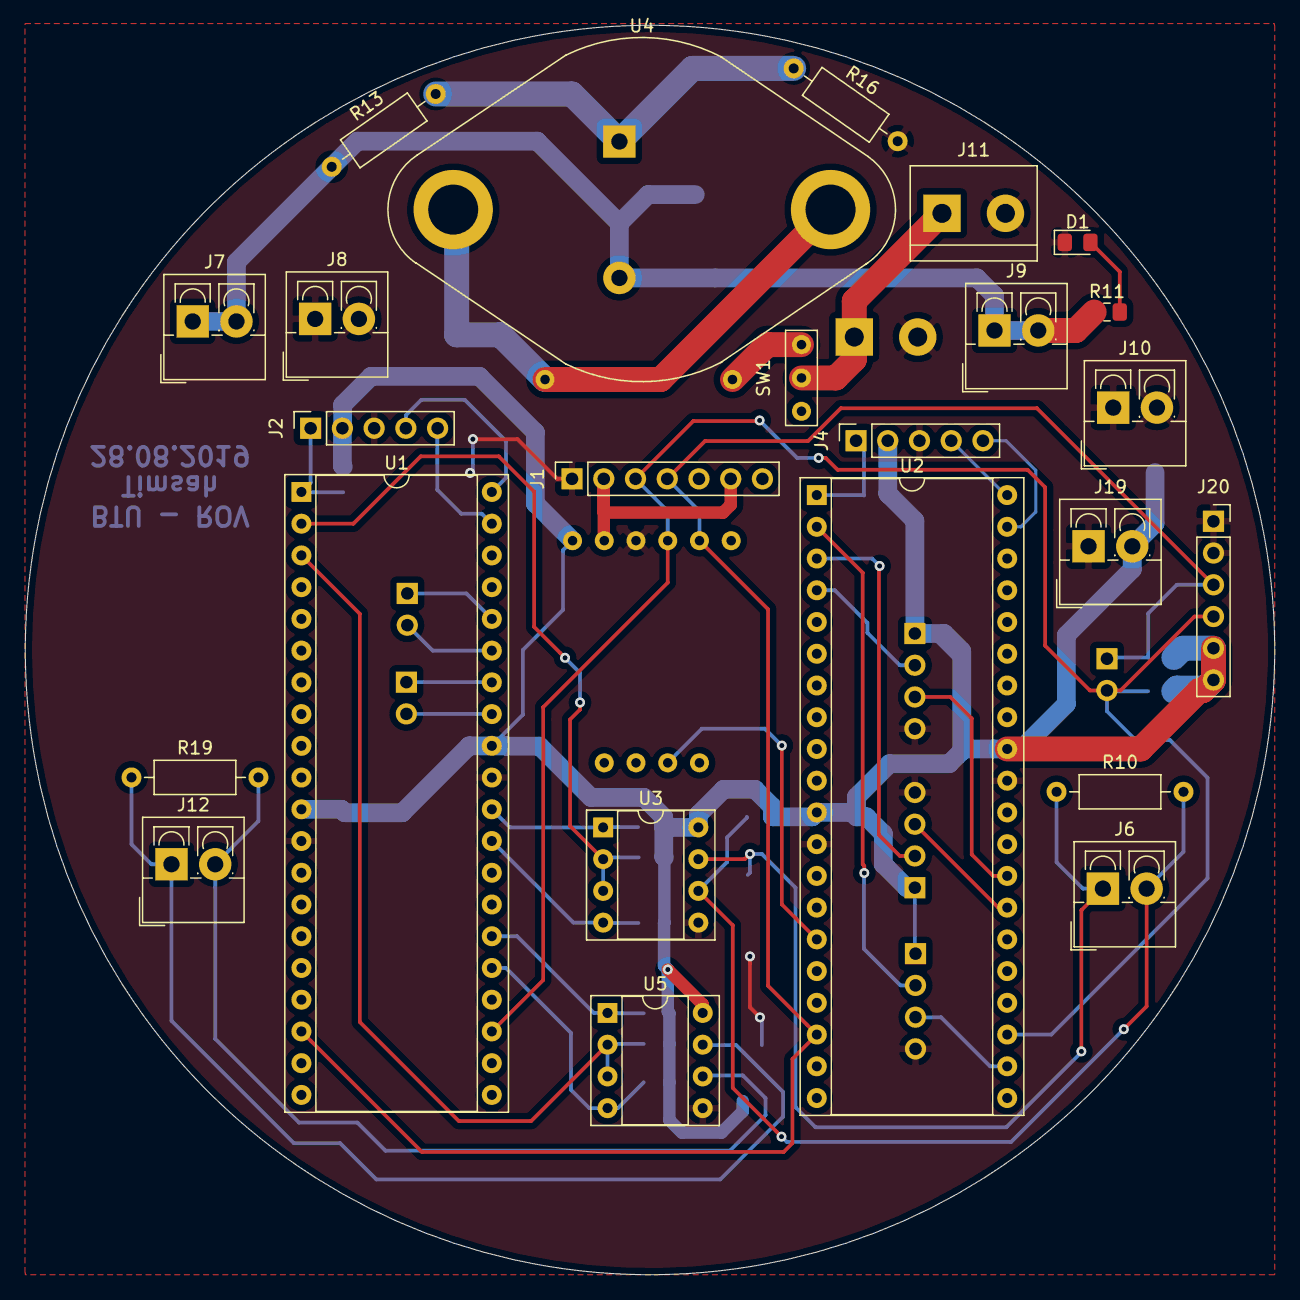
[picture p32: board Timsah_Main_Board.kicad_pcb from above]

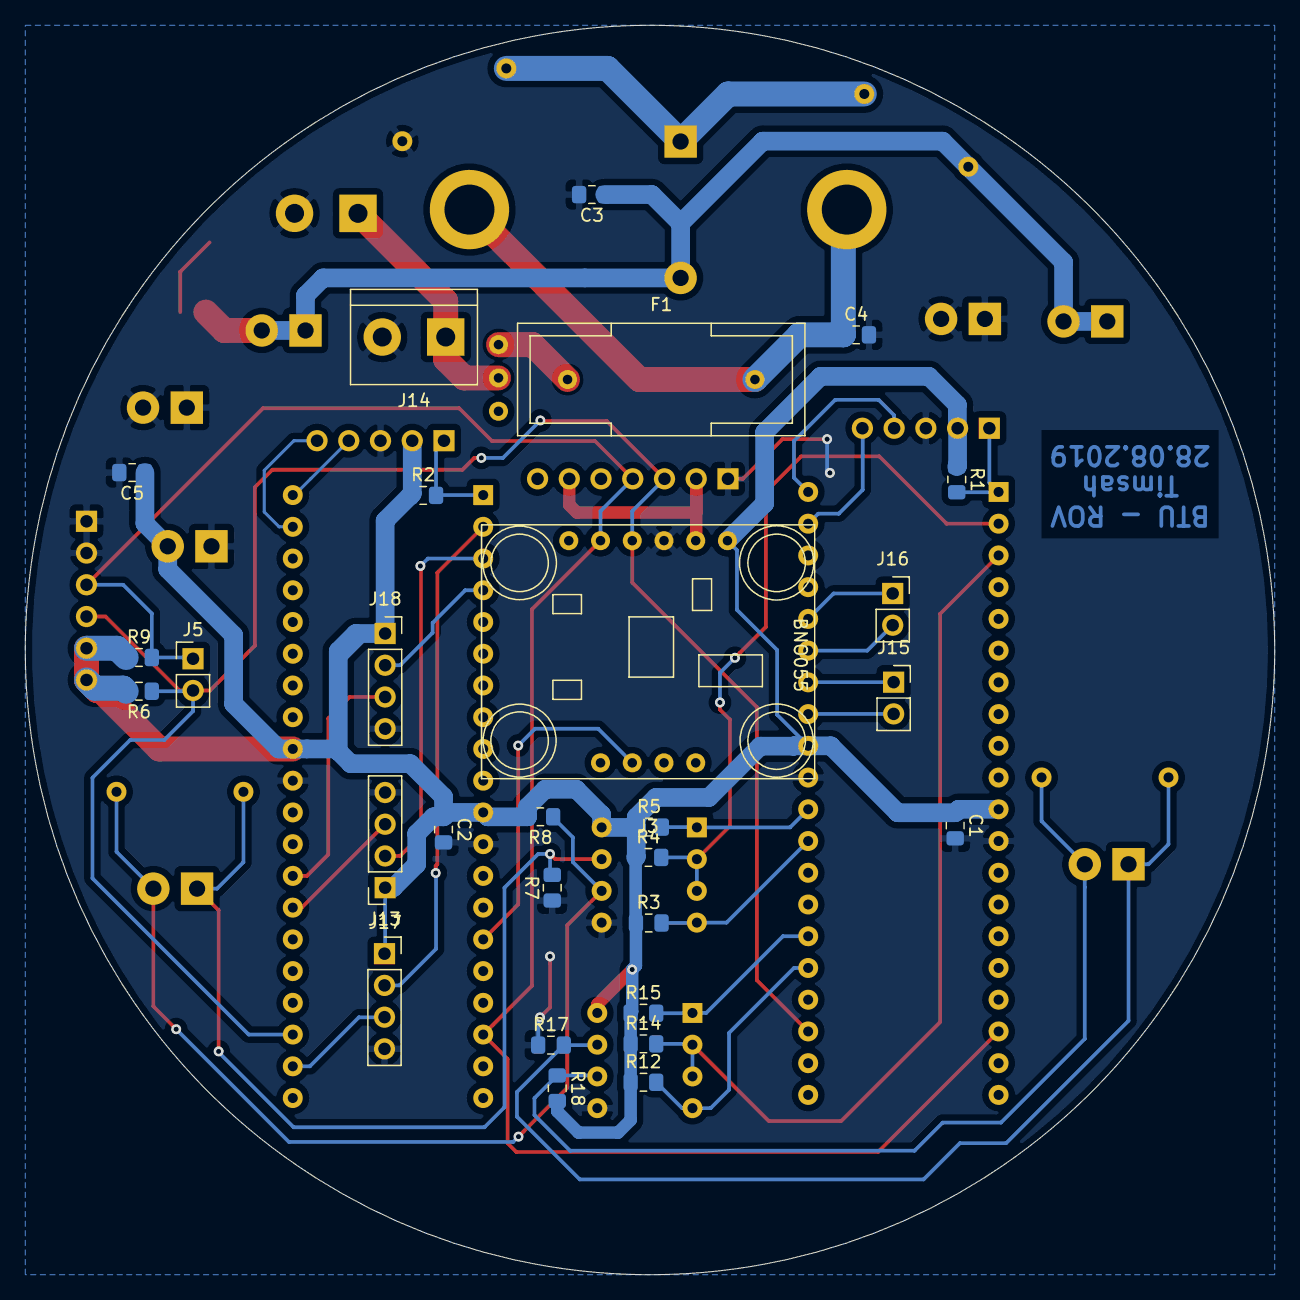
[picture p33: board Timsah_Main_Board.kicad_pcb from below]

Board: 2 copper layers, 100.0 x 100.0 mm, 52 parts (28 on the bottom side), 38 nets.
