btu-rov/Timsah/Timsah_Remote-Control/Timsah_Remote-Control.kicad_pcb

## KiCad design Timsah_Remote-Control/Timsah_Remote-Control.kicad_pcb (2019-08-28)

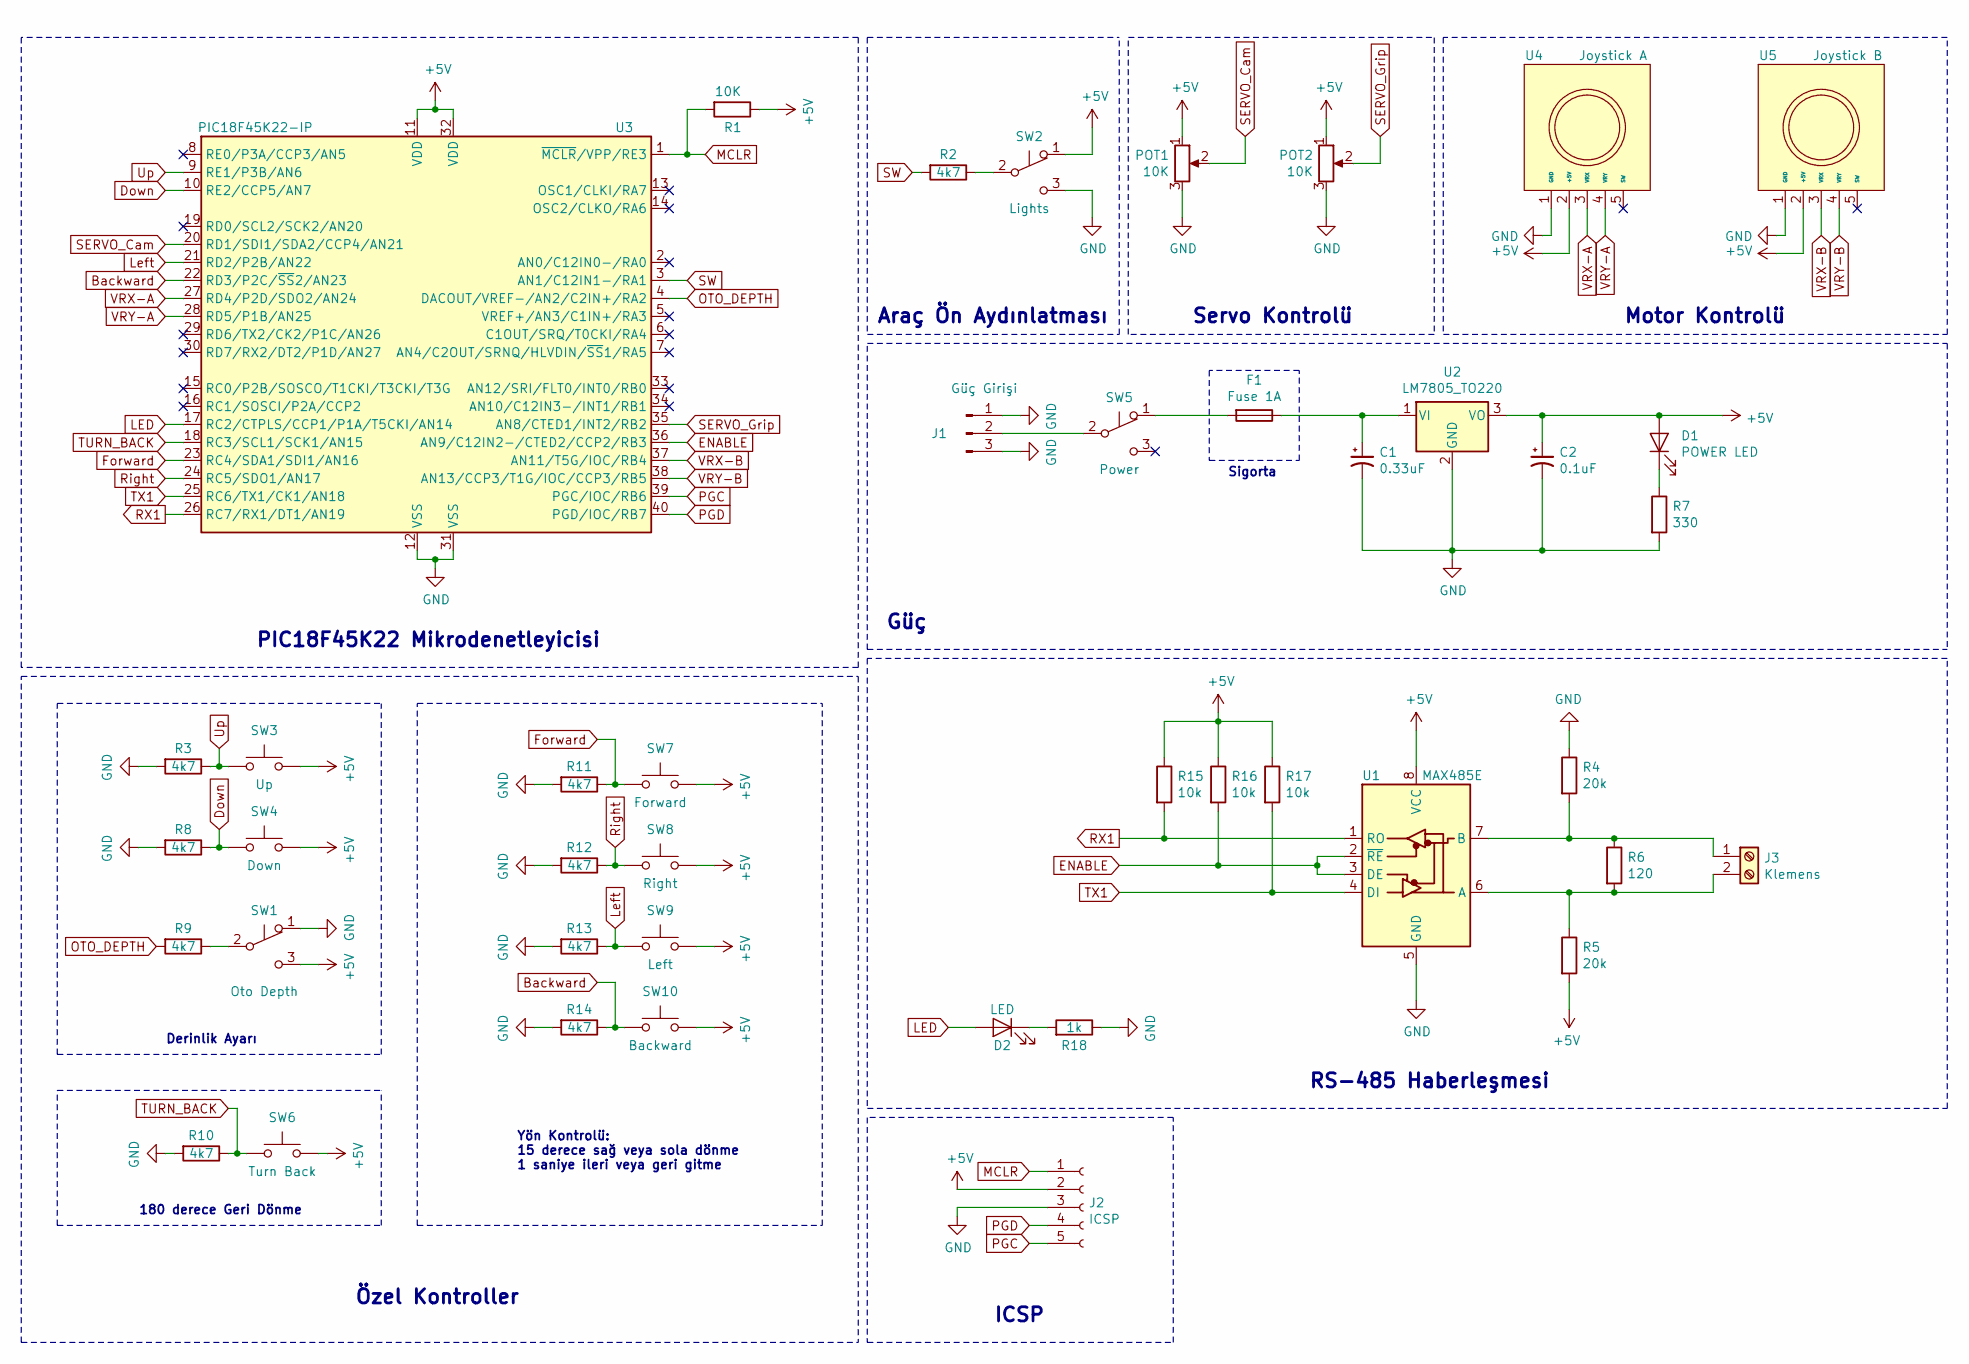
[picture p34: schematic Timsah_Remote-Control.sch, Timsah: Remote Control]

Parts:
C1: 0.33uF; C_Radial_D5.0mm_H7.0mm_P2.00mm
C2: 0.1uF; C_Radial_D5.0mm_H7.0mm_P2.00mm
D1: POWER LED; LED_D5.0mm
D2: LED; LED_D5.0mm
F1: Fuse 1A; Fuseholder_23x9x10mm
J1: Güç Girişi; PinHeader_1x03_P2.54mm_Vertical
J2: ICSP; PinHeader_1x05_P2.54mm_Vertical
J3: Klemens; TerminalBlock_4Ucon_1x02_P3.50mm_Vertical
POT1, POT2: 10K; Potentiometer_Lineer-B503
R1: 10K; R_Axial_DIN0207_L6.3mm_D2.5mm_P10.16mm_Horizontal
R2, R3, R8, R9, R10, R11, R12, R13, R14: 4k7; R_Axial_DIN0207_L6.3mm_D2.5mm_P10.16mm_Horizontal
R4, R5: 20k; R_Axial_DIN0207_L6.3mm_D2.5mm_P10.16mm_Horizontal
R6: 120; R_Axial_DIN0207_L6.3mm_D2.5mm_P10.16mm_Horizontal
R7: 330; R_Axial_DIN0207_L6.3mm_D2.5mm_P10.16mm_Horizontal
R15, R16, R17: 10k; R_Axial_DIN0207_L6.3mm_D2.5mm_P10.16mm_Horizontal
R18: 1k; R_Axial_DIN0207_L6.3mm_D2.5mm_P10.16mm_Horizontal
SW1: Oto Depth; SW_Slide_1P2T_0.105pitch
SW2: Lights; SW_Slide_1P2T_0.105pitch
SW3: Up; SW_PUSH_6mm_H5mm
SW4: Down; SW_PUSH_6mm_H5mm
SW5: Power; SW_Slide_1P2T_0.105pitch
SW6: Turn Back; SW_PUSH_6mm_H5mm
SW7: Forward; SW_PUSH_6mm_H5mm
SW8: Right; SW_PUSH_6mm_H5mm
SW9: Left; SW_PUSH_6mm_H5mm
SW10: Backward; SW_PUSH_6mm_H5mm
U1: MAX485E; DIP-8_W7.62mm_Socket
U2: LM7805_TO220; TO-220-3_Vertical
U3: PIC18F45K22-IP; DIP-40_W15.24mm_Socket
U4: Joystick A; Joystick
U5: Joystick B; Joystick

Connections:
+5V: C2.1, D1.2 (A), J2.2, POT1.1, POT2.1, R1.1, R5.2, R15.1, R16.1, R17.1, SW1.3 (C), SW2.1 (A), SW3.2, SW4.2, SW6.2, SW7.2, SW8.2, SW9.2, SW10.2, U1.8 (VCC), U2.3 (VO), U3.11 (VDD), U3.32 (VDD), U4.2 (+5V), U5.2 (+5V)
Backward: R14.1, SW10.1, U3.22 (RD3/P2C/~SS~2/AN23)
Down: R8.1, SW4.1, U3.10 (RE2/CCP5/AN7)
ENABLE: R16.2, U1.2 (~RE), U1.3 (DE), U3.36 (AN9/C12IN2-/CTED2/CCP2/RB3)
Forward: R11.1, SW7.1, U3.23 (RC4/SDA1/SDI1/AN16)
GND: C1.2, C2.2, J1.1, J1.3, J2.3, POT1.3, POT2.3, R3.2, R4.1, R7.2, R8.2, R10.2, R11.2, R12.2, R13.2, R14.2, R18.1, SW1.1 (A), SW2.3 (C), U1.5 (GND), U2.2 (GND), U3.12 (VSS), U3.31 (VSS), U4.1 (GND), U5.1 (GND)
LED: D2.2 (A), U3.17 (RC2/CTPLS/CCP1/P1A/T5CKI/AN14)
Left: R13.1, SW9.1, U3.21 (RD2/P2B/AN22)
MCLR: J2.1, R1.2, U3.1 (~MCLR~/VPP/RE3)
unnamed: C1.1, F1.1, U2.1 (VI)
unnamed: D1.1 (K), R7.1
unnamed: D2.1 (K), R18.2
unnamed: F1.2, SW5.1 (A)
unnamed: J1.2, SW5.2 (B)
unnamed: J3.1, R4.2, R6.1, U1.7 (B)
unnamed: J3.2, R5.1, R6.2, U1.6 (A)
unnamed: R2.1, SW2.2 (B)
unnamed: R9.1, SW1.2 (B)
OTO_DEPTH: R9.2, U3.4 (DACOUT/VREF-/AN2/C2IN+/RA2)
PGC: J2.5, U3.39 (PGC/IOC/RB6)
PGD: J2.4, U3.40 (PGD/IOC/RB7)
RX1: R15.2, U1.1 (RO), U3.26 (RC7/RX1/DT1/AN19)
Right: R12.1, SW8.1, U3.24 (RC5/SDO1/AN17)
SERVO_Cam: POT1.2, U3.20 (RD1/SDI1/SDA2/CCP4/AN21)
SERVO_Grip: POT2.2, U3.35 (AN8/CTED1/INT2/RB2)
SW: R2.2, U3.3 (AN1/C12IN1-/RA1)
TURN_BACK: R10.1, SW6.1, U3.18 (RC3/SCL1/SCK1/AN15)
TX1: R17.2, U1.4 (DI), U3.25 (RC6/TX1/CK1/AN18)
Up: R3.1, SW3.1, U3.9 (RE1/P3B/AN6)
VRX-A: U3.27 (RD4/P2D/SDO2/AN24), U4.3 (VRX)
VRX-B: U3.37 (AN11/T5G/IOC/RB4), U5.3 (VRX)
VRY-A: U3.28 (RD5/P1B/AN25), U4.4 (VRY)
VRY-B: U3.38 (AN13/CCP3/T1G/IOC/CCP3/RB5), U5.4 (VRY)

Notes on the sheet:
Motor Kontrolü
Servo Kontrolü
Araç Ön Aydınlatması
Güç
RS-485 Haberleşmesi
ICSP
PIC18F45K22 Mikrodenetleyicisi
Sigorta
Derinlik Ayarı
180 derece Geri Dönme
Yön Kontrolü: 15 derece sağ veya sola dönme 1 saniye ileri veya geri gitme
Özel Kontroller

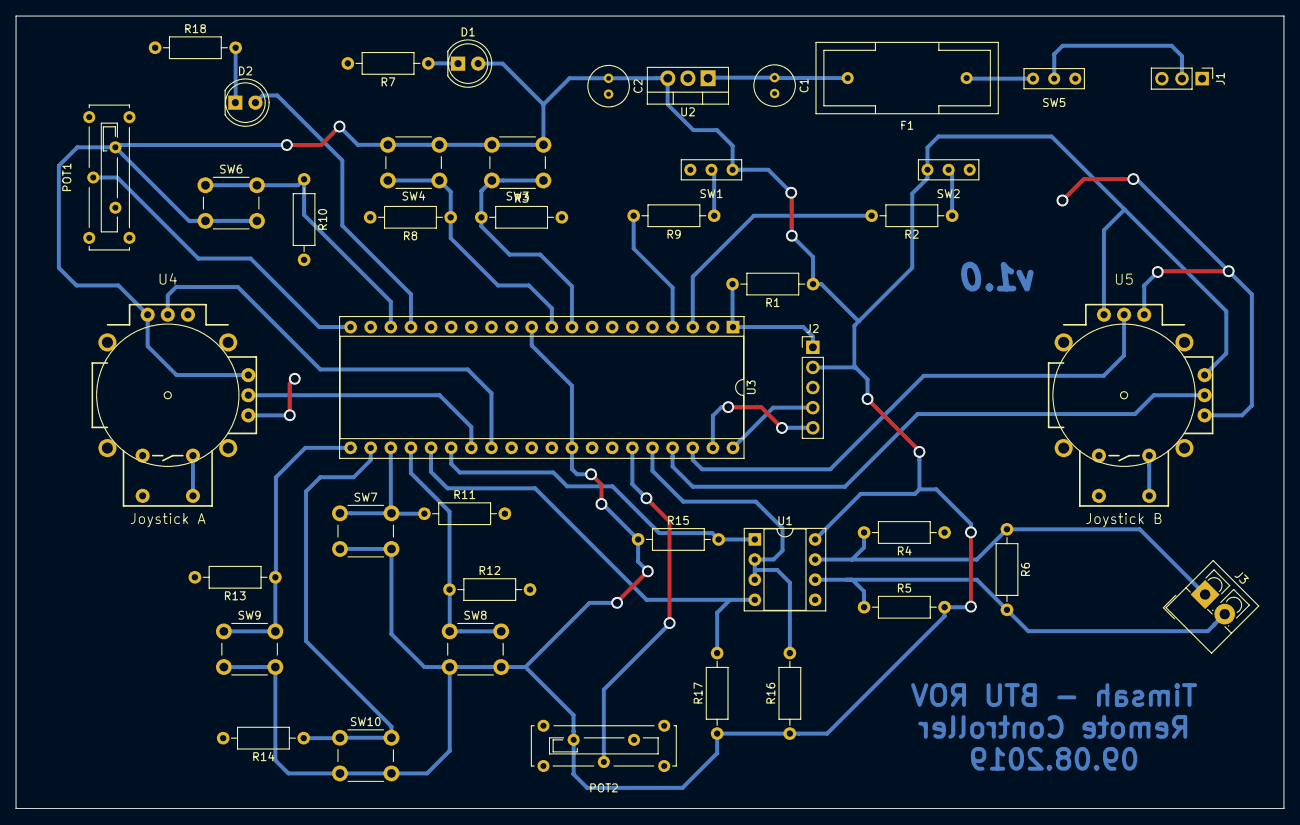
[picture p35: board Timsah_Remote-Control.kicad_pcb from above]

Board: 2 copper layers, 160.0 x 100.0 mm, 43 parts (0 on the bottom side), 33 nets.
