btu-rov/Timsah/(commit log)

2019-03-25 Update arduino test code.
    Added changin tmp value.
2019-04-19 Changed files locations.
    [Timsah_Remote-Control.kicad_pcb, Timsah_Remote-Control.sch]
2019-04-20 Added speed graphs.
    - Added SpeedX and SpeedY graphs.
    - Added Graph's labels.
    - Color changes.
    - Temperature graph min and max changes.
2019-04-21 Update index.js
    - Visualize random datas.
    - Added speed and sonar datas.
    - Added rendering charts.
2019-04-21 Initialize Schematic
    [Timsah_Kumanda.kicad_pcb, Timsah_Kumanda.sch, Timsah_Remote-Control.sch]
2019-04-21 Remote controller schematic update.
    - Some titels fixed
    - Microcontroller updated
    - Project library edited
    - Some oriantations changed
    [Timsah_Remote-Control.kicad_pcb, Timsah_Remote-Control.sch]
2019-04-23 Added special controls.
    [Timsah_Remote-Control.sch]
2019-04-23 Added schematic pdf.
2019-04-23 Added motor speed, tilt and sonar datas.
2019-04-23 GUI updated.
    - Added motor speeds
    - Added tilt graph
    - Added sonar graphs
    - Changed colors
2019-04-24 Initialize Main Board
    [Timsah_Main_Board.kicad_pcb, Timsah_Main_Board.sch]
2019-04-27 Update Main Board.
    [Timsah_Main_Board.sch]
2019-05-02 Schematic Update
    [Timsah_Main_Board.sch]
2019-05-17 Added main body that is assembled with other parts
2019-05-17 Added other parts.
    [Motor_Holder.step, Robot_Arm.step, Sonar.step, Transparent_Tube.step]
2019-07-15 Update schematics.
    [Motor-Controle.sch, Timsah_Main_Board-PWM.sch, Timsah_Main_Board.sch, Timsah_Remote-Control.sch]
2019-07-24 Schematic updates.
    [Motor-Controle.sch, Timsah_Main_Board.sch, Timsah_Remote-Control.sch]
2019-07-26 Remote update.
    - PCB design started.
    [Joystickcolor.step, LITTLEFUSE_FuseBlock_646_v2.step, Slide potentiometers.step, Timsah_Remote-Control.kicad_pcb, Timsah_Remote-Control.sch, Vertical slide switch SS-12D00G3 High Knob 3mm SPDT v2.step]
2019-08-01 Added software.
    [Motor-Controle.sch, Timsah_Main_Board.sch]
2019-08-04 I2C Update.
    - Fixed i2c read
    - Added BNO055 setup library.
    [bno055.c, bno055.h, config.c, config.h, i2c1.c, i2c1.h, interrupts.c, main.c]
2019-08-05 v1.0 of libraries.
    - Added cmbus protochol.
    - Some small changes.
    [Timsah_Remote-Control.sch]
2019-08-08 Added remote controle PCB design.
    [Timsah_Remote-Control.kicad_pcb]
2019-08-08 Remote control board recreated.
    [Timsah_Remote-Control.kicad_pcb, Timsah_Remote-Control.sch]
2019-08-08 Remote controller joystick pins changed.
    Joystick A pins do not connected to analog pins.
    [Timsah_Remote-Control.kicad_pcb, Timsah_Remote-Control.sch]
2019-08-28 Hardware Update
    [Adafruit_BNO055_AP214.STEP, LITTLEFUSE_FuseBlock_646_v2.step, Motor-Controle.sch, ScrewTerminal.STEP, Timsah_Main_Board.sch, Timsah_Remote-Control.kicad_pcb, Timsah_Remote-Control.sch, Vertical slide switch SS-12D00G3 High Knob 3mm SPDT v2.step]
2019-08-28 Update PCB
    [Timsah_Main_Board-B_Cu.gbr, Timsah_Main_Board-B_Mask.gbr, Timsah_Main_Board-B_Paste.gbr, Timsah_Main_Board-B_SilkS.gbr, Timsah_Main_Board-Edge_Cuts.gbr, Timsah_Main_Board-F_Cu.gbr, Timsah_Main_Board-F_Mask.gbr, Timsah_Main_Board-F_Paste.gbr]
